paulkilroy/ChurchCam/README.md

# ChurchCamController

## TODO

- [ ] Make auto center
- [ ] Add settings to webserver
- [x] Make scad with bigger screen
