paulkilroy/ChurchCam/docs/pinout.html

Olimex ESP32-PoE · WROOM & WROVER

# ChurchCam Remote Pinout

The board as it really sits — both GPIO headers in physical pin order. The joystick and buttons wire to the header pins; the display plugs into the UEXT connector beside it. One wiring runs on both modules, so the two recall buttons share GPIO34 as a single analog input (one resistor) and GPIO16 is left free (the WROVER's PSRAM owns it). Colours mark what each pin does. Below: the button ladder, then the joystick detail (orientation, polarity, wiring), the full wire-by-wire list, and a bench test.

Pan · GPIO33 Tilt · GPIO35 Zoom · GPIO36 Buttons VCC (3V3) GND On-chip / reserved Display net (via UEXT)

## Wiring

The board & the UEXT connector

Both headers, pin-for-pin. The joystick's three wipers — pan, tilt, zoom — and the buttons land on the right header; power rails on the left. Both recall buttons share GPIO34 as one analog input (below). Dashed pins are the display's nets, wired through UEXT — don't reuse them. GPIO16 and GPIO0 sit empty: each is free on a WROOM but taken by the WROVER (PSRAM / ETH clock), so the one wiring fits both.

Eight wires go to the panel — teal is the display bus, red VCC, black GND. Pin 4 (GPIO36) is the zoom wiper, wired on the EXT header (dotted), not through this ribbon — pick one connector for it, never both. Pin 5 (GPIO16) is now left empty: it's the old recall-1 pin, freed because the WROVER module uses GPIO16 for PSRAM.

Drawn from the wiring (back) side, so left-to-right matches the panel: Recall 2, Recall 1, onboard BUT1, then Override. Recall 1, Recall 2 and BUT1 share one input-only pin, GPIO34, held high by the onboard 10k pull-up (R48) — just one resistor, no second run to the header: Recall 1 is a bare button to GND (ADC ≈ 0); bridge a single 10k straight from Recall 1 to Recall 2, other leg to GND (ADC ≈ 2048); the onboard BUT1 (220Ω, ADC ≈ 88) doubles as a spare Recall 1. Bands: >3000 none · 1200–3000 recall 2 · <1200 recall 1 (Recall 1's hard short wins, so both-press = recall 1; no dead zone). Override is separate — its own pin GPIO32 with an internal pull-up, a plain button to GND, read as a digital LOW.

Room to expand? Not on the dual-module wiring.

The two pins that look spare are each taken by the WROVER — so for one wiring that runs on both modules, leave both empty:

- GPIO0 — free on a WROOM, but on a WROVER it carries the Ethernet 50 MHz clock (the WROVER clocks ETH out on GPIO0 because PSRAM took GPIO16/17). A button there would break Ethernet. Even on a WROOM it's a boot-strap pin — pressed during power-up/reset it drops the chip into firmware-download mode — so it's a poor home for a frequently-used control.
- GPIO16 — also free on a WROOM only. On a WROVER the module's PSRAM owns GPIO16/17, so a button there breaks the module.
- GPIO1 and GPIO3 are the USB serial console (UART0 TX/RX, through the CH340). Free only if you give up serial logging and USB flashing — you'd rely on OTA updates instead.
- GPIO2 is the display backlight (via UEXT) and itself a strapping pin — not available.
- Everything else is taken (joystick, buttons, display) or committed: GPIO34/35/36/39 are input-only (joystick axes + the recall buttons), GPIO39 also reads the supply voltage, and the rest of the chip is the Ethernet PHY. To add controls you'd combine more buttons onto the existing ladder, add an I²C/ADC expander, or free up the serial pins. (On a WROOM-only build, GPIO0 and GPIO16 open back up.)

## Orientation · polarity · wiring

Joystick detail

Three identical, unlabeled pots and a stick that mounts either way — so wire by colour and motion, never by which pot "looks like" pan, then prove it on the display radar before install.

Green = Pan · GPIO33 Yellow = Tilt · GPIO35 Blue = Zoom · GPIO36 Red = VCC 3V3 White = GND

1Which pot is which — by motion

The pots are twins — identify them by motion, not by looks. Shown from the wiring side (mirror of the operator's view), so Tilt sits on the right here — on the front it's on the left. A gimbal pot sits perpendicular to the axis it senses: the pot across the left↔right travel is PAN, the one across up↕down is TILT. Foolproof check: waggle the stick left–right and watch the two pots — the shaft that turns is Pan (green). Waggle up–down — that one is Tilt (yellow). The ZOOM pot is the twist knob on top.

2Polarity — this sets direction

Hold the pot in your hand, stick pointing up and the three legs facing you — a hold-in-hand reference, so it doesn't matter which way the pot ends up mounted. Left leg = VCC (red), centre = wiper (the axis colour), right leg = GND (white). Wire both gimbal pots (Pan & Tilt) exactly this way. Swapping a pot's two outer legs reverses its voltage sweep and inverts that axis — that's the "left goes right" failure. The ZOOM knob already has this baked into its 3-wire lead: red = VCC, white = GND, black = wiper (extend the black with your blue wire).

3Wire it — one power rail, three wipers

The red (VCC) and black (GND) wires are one shared rail — the board's 3V3 and GND link straight through all three pots. Order doesn't matter — it's one continuous bus (you solder it from the far end: zoom→tilt→pan→board). Only the centre wiper is unique to each: Zoom → GPIO36, Tilt → GPIO35, Pan → GPIO33. Board pins are in physical header order — note GPIO34, the recall-button pin, sits in the gap between Tilt and Pan and takes no joystick wire.

The one thing that silently bites you: keep every pot's VCC on the left / GND on the right (the polarity card above) as you chain them. It's easy to flip a pot end-for-end while soldering the daisy-chain — and a flipped pot inverts that axis. If two axes come out swapped, you crossed the green/yellow wipers; if one axis is reversed, you flipped that pot's outer legs.

## Connection list

Wire by wire, by where it lands

Component | Pin | Lands on
Display → UEXT connector (10-wire ribbon)
VCC | 3V3 | UEXT 1
GND | GND | UEXT 2
RESET | GPIO4 | UEXT 3
MOSI | GPIO13 | UEXT 6
CS | GPIO15 | UEXT 7
LED (backlight) | GPIO2 | UEXT 8
SCK | GPIO14 | UEXT 9
DC | GPIO5 | UEXT 10
Joystick & buttons → right header (EXT2)
Pan wiper | GPIO33 | header · ADC1
Tilt wiper | GPIO35 | header · ADC1
Zoom wiper | GPIO36 | header · ADC1
Recall 1 button | GPIO34 | bare button → GND (no resistor; onboard BUT1 too)
Recall 2 button | GPIO34 | 10k bridged from Recall 1 → button → GND
Override button | GPIO32 | header
Power rails → left header (EXT1)
Joystick VCC rail | 3V3 | left header
Joystick / button ground | GND | left header
On-chip on WROVER — leave empty (free on a WROOM)
Ethernet clock (WROVER) | GPIO0 | left header · also the boot pin
PSRAM (WROVER) | GPIO16 | right header

## Testing

Prove the board & buttons before you install

Orientation (best-guess reference — the radar is the real judge): mount the controller so the operator's “up” on the stick is physically up and the wire lead exits toward the operator. Because Pan/Tilt were identified by motion (card 1), the exact mount doesn't change the wiring — but it must match what the operator expects, and the test below confirms it.

1. Power the controller and look at the radar on its display.
2. Push the stick UP → the dot must go UP. Push RIGHT → dot RIGHT. Push LEFT/DOWN → matching.
3. Twist zoom in → the zoom bar fills up; twist out → it empties.
4. Buttons: press Recall 1, Recall 2 and Override in turn. Recall 1 & 2 share GPIO34 — watch the serial log line recall ladder ADC=…: rest ≈ 4095, Recall 2 ≈ 2048, Recall 1 ≈ 0 (onboard BUT1 ≈ 88 also reads as Recall 1). Both at once → ≈ 0 = Recall 1 (its hard short wins; no both-press dead zone). Each button must land in its own band, and Override (its own pin, GPIO32) must read separately.
5. All four directions, zoom, and every button correct → ship it. Anything wrong → the table:

What you see | What's wrong | Fix
Up/down moves the camera sideways & left/right moves it up/down | Pan & Tilt wipers crossed | Swap the green and yellow wires at GPIO33 ↔ GPIO35
Push UP → dot goes DOWN | Tilt axis inverted | Swap the Tilt pot's two outer legs (red ↔ white)
Push RIGHT → dot goes LEFT | Pan axis inverted | Swap the Pan pot's two outer legs (red ↔ white)
Zoom in empties the bar (backwards) | Zoom axis inverted | Swap the Zoom knob pot's two outer legs
An axis doesn't move the dot at all | Wiper open, or VCC/GND not reaching that pot | Check that pot's centre wiper to its GPIO, and that the red/white rail is unbroken through the chain

Field option (no soldering): a mis-wired unit can also be corrected in software — a per-axis Invert / swap in the config page — if we add it. Say the word and I'll build it so a bad unit is a checkbox, not a rework.

ChurchCam · Olimex ESP32-PoE, WROOM & WROVER (one wiring) · ILI9341 over native HSPI, on UEXT · JH-D400X joystick: Pan GPIO33 / Tilt GPIO35 / Zoom GPIO36, VCC-left polarity, verify on the display radar · from Display.cpp + Pinouts[REV_OLIMEX] · pins & header order verified against the ESP32-PoE Rev.E schematic
