paulkilroy/ChurchCam/docs/design/header-and-edge-states.html

ChurchCam · header + buttons + edge states · v2

# Signal bars, subsystem pills, and live button feedback Plus the fixed edge states — Connecting now amber with a real wordmark, and Network-lost matches what the firmware actually does (just keeps retrying).

The header now folds three things into one strip: how the device is connected, the state of the switcher, and a flash whenever you press a physical button.

## The header — signal + subsystem pills

Wi-Fi strength bars + host/IP/RSSI on the left; the switcher's state as colored pills on the right. Normal service:

4-bar signal · churchcam · 10.13.37.2 · -54 dB | ATEM ✓ · big ● ON AIR (off air = dim outline)

## Button-press pills

Each press flashes a pill in the header's right slot. A tap recalls a preset (brief green flash); holding OVERRIDE while you tap saves the current position — which triggers the full-screen confirmation in the next section.

OVERRIDE held — red, driving the PROGRAM camera

Tap a preset — RECALL (green flash)

Idle — status pills showing

Maps to PIN_OVERRIDE, PIN_RECALL_1, PIN_RECALL_2. Override is held (red while driving live). Tap = recall; OVERRIDE + tap = save → full-screen popup. Pill text is the same size as ON AIR now.

## Edge states — fixed

Distinct full-screen layouts. Setup + Connecting/Lost share the amber "you need to do something / hang tight" language; hard failures go red.

### Preset saved (full-screen)

~2.5s takeover after OVERRIDE + tap. Shows the camera and the saved P/T/Z position, then the console returns. The control loop keeps running underneath.

when: OVERRIDE held + preset button tapped

### Setup / AP mode

Reachable only on its own hotspot. SSID + IP shown like fields to copy.

when: hotspot up, no station/Ethernet link

### Connecting / reconnecting

Amber now, wordmark up top. Says whether it's a first connect or a reconnect — but no fake countdown; it just keeps trying.

when: no IP yet (boot or link drop)

### No ATEM (degraded)

Console still drives directly; tally box becomes an amber DIRECT panel. Text no longer overlaps the radar.

when: network up, ATEM unreachable

### Updating firmware

Full-screen progress + a hard "do not power off." Locks out everything during OTA.

when: /update OTA in progress

### Input has no camera

ATEM on a laptop/media input → says so instead of a dead tally.

when: active input has no camera IP

On "network lost": the firmware doesn't time-out to the AP after a drop — if Wi-Fi was working it just retries forever (restart to reconfigure). So there's no separate red "lost" screen with a countdown; the Connecting screen simply reads Reconnecting… when it had a link before. Faithful to the code, same as our rule for the ATEM sim.
