paulkilroy/ChurchCam/docs/design/screen-concepts.html

ChurchCam · 320×240 · Console + Radar — refined

# Now with a live camera bus The active camera's status reads in caps inside its tally box; the old PGM/PVW text becomes a strip of all 8 inputs — dim when offline, tallied PRG / PVW when live.

One glance now tells you which camera you're driving and its state, where the joystick is, what the whole switcher bus looks like, and whether you're streaming — without a single ambiguous label.

Console + Radar + 8-input camera strip · rendered at ~2.3× (real screen is 320×240)

## The camera strip · 8 inputs

1PRG

PROGRAM

2PVW

PREVIEW

3

connected

4!

configured,
no reply

5

not configured

The tile you're driving gets a white underline. Program/Preview come from getProgramInputVideoSource() / getPreviewInputVideoSource(); the rest map to cached camera status — amber "!" = has an IP but not responding (CAMERA_DOWN), dim = no IP set (CAMERA_NA).

## What's on screen

- Tally box — frame color = Program (red) / Preview (green) / Off; caps status inside: number, name, ● reachable
- Radar — pan/tilt dot live; ring matches tally color; zoom on the right rail
- Camera strip — all 8 inputs, dim when offline, PRG/PVW tally badges
- On-Air pill — livestream state, kept separate from Program
- Histogram — TX/sec, thin along the bottom
- Open Q: 8 tiles across 320px are ~35 px — number + tally read fine, but no room for names. OK?

Ready to build → this is a clean, buildable layout. Say go and I'll implement it in Display.cpp against the sim, where you'll see the real pixel-font render and the strip/radar actually move — then we fine-tune spacing, the caps status wording, and colors on real glass.
