paulkilroy/ChurchCam/docs/manual.html

◐ theme

ChurchCam · Olimex ESP32-PoE PTZ Controller

# Operator & Setup Manual

ChurchCam is a joystick controller for pan/tilt/zoom cameras. It follows your ATEM switcher's preview bus — so you always drive whatever camera is cued next — and speaks both VISCA and ONVIF over Ethernet or Wi-Fi. This guide covers the on-screen display, the joystick and buttons, first-time setup, and the web configuration page.

320×240 display3-axis joystickoverride + 2 preset buttonsVISCA · ONVIFweb config

## 1The screen at a glance

The main "console" screen shows everything you need while driving: which camera you're on and whether it's live, where the joystick is, the whole switcher bus, and whether the device is talking.

The console — a full breakdown of every region is in Reading the display.

## 2Joystick & buttons

Three physical controls do everything. The joystick drives the camera; the three buttons handle live override and presets.

Control | Action
Joystick — left / right | Pan the camera
Joystick — up / down | Tilt the camera
Joystick — zoom axis | Zoom in / out
OVERRIDE button (hold) | Drive the Program (live) camera instead of Preview — the tally box turns red. Also the "shift key" for saving presets.
PRESET 1 / 2 — tap | Recall that preset (camera moves to the saved position)
OVERRIDE + PRESET 1/2 | Save the current position to that preset

Rule of thumb

A quick tap on a preset button recalls. To save, hold OVERRIDE and tap the preset button — you'll get a full-screen "PRESET SAVED" confirmation.

## 3Reading the display

Every colour and pill on the screen means something specific. Here's the whole vocabulary.

### The header

1. Signal — Wi-Fi strength bars, or a wired icon on Ethernet.
2. Host & IP — the device's hostname, address, and Wi-Fi signal (dBm).
3. ATEM — green pill when the switcher is connected; amber NO ATEM when it isn't.
4. ON AIR — big and red when the switcher is livestreaming; dim OFF AIR otherwise — not the same as a camera being on Program.

### The whole console

1. Status header — signal, hostname/IP, ATEM link, and the big ON AIR / OFF AIR streaming indicator.
2. Tally box — the camera you're driving; the frame is red on Program, green on Preview.
3. Radar — live pan/tilt position (dot) and zoom (right rail).
4. Camera bus — all 8 inputs at a glance, with tally and connection state.
5. TX graph — commands the device is sending, per second.

### Tally — Program vs Preview

The tally box frame tells you, at a glance, whether the camera you're driving is live:

Frame | Meaning
PROGRAM (red) | This camera is live on air. Move with care.
PREVIEW (green) | This camera is cued next. Safe to reframe.
OFF (grey) | Not on either bus.

### The camera bus strip

All eight inputs, always visible. Each tile shows the input number, its tally, and whether a camera is actually reachable there:

Tile | State
red · PRG | On Program (live)
green · PVW | On Preview (next)
grey | Connected, reachable
amber · ! | Configured but not responding
dim | No camera configured on this input

A white underline marks the tile you're currently driving.

### Radar & TX graph

The radar crosshair shows live pan/tilt as a moving dot, with zoom on the right rail; both turn red when you're on a Program camera. The TX graph along the bottom is a running count of commands the device sends each second — a quiet heartbeat that lets you see it's actually talking to the cameras.

## 4Driving cameras & presets

You never pick a camera number by hand — the controller follows the switcher.

### Which camera you're driving

By default the controller drives whatever camera is on the ATEM's Preview bus. Cue a camera to preview on the switcher, and the joystick moves that camera — the tally box shows it green (PREVIEW).

Need to nudge the shot that's live? Hold OVERRIDE — now you're driving the Program camera, and the tally box (and radar) turn red so you never forget the shot is on air. Release to go back to driving Preview.

### Presets

- Recall a preset — tap PRESET 1 or 2. The camera moves to the saved shot; the header flashes PRESET n RECALL.
- Save a preset — frame the shot, then hold OVERRIDE and tap PRESET 1 or 2. A full-screen confirmation shows the camera and the position you saved.

## 5Button feedback & saving

Every button press gets visible feedback so you know the device saw it.

#### Override held

#### Preset recalled (tap)

### Saving a preset — the confirmation

Holding OVERRIDE and tapping a preset saves the shot and takes over the whole screen for a couple of seconds. The joystick keeps working underneath, then the console returns.

1. Which preset — the slot you just saved to.
2. Camera — the number and name it was saved for.
3. Position — the pan / tilt / zoom you stored, shown as bars.
4. Recall — tap the same button later to return to this shot.

## 6First-time setup

Out of the box (or after an erase) the device has no network, so it hosts its own hotspot for configuration.

1. Join its Wi-Fi — on your phone or laptop, connect to the ptz-setup network.
2. Open the config page — browse to 192.168.4.1 (shown on screen).
3. Enter your Wi-Fi, the ATEM's IP, and your cameras — then Save. The device reboots and joins your network.

After setup

Once it's on your network the screen shows the device's real IP and hostname (churchcam by default) — browse to that hostname or IP anytime to change settings.

## 7The configuration page

The web page (served by the device) has four tabs: Status, Config, Logs, and Firmware. Browse to the device's hostname (churchcam.local) or IP to open it.

http://churchcam.local

Church Cam Controller

PTZ made EZ

StatusConfigLogsFirmware

Network Config

Network Name (SSID)

KilroyNetwork

Network Password

••••••••••

Static IP Address?

ATEM Mini Pro IP

10.0.4.40

CAM1 [ATEM In1]

VISCA

UDP

10.0.4.62

52381

CAM2 [ATEM In2]

VISCA

TCP

10.0.4.63

52382

CAM3 [ATEM In3]

ONVIF

TCP

10.0.4.64

8083

CAM4 [ATEM In4]

ONVIF

TCP

10.0.4.65

8084

Discover Cameras

Submit

The Config tab, matching the real page: form-floating network fields and one input-group row per camera (name · VISCA/ONVIF · UDP/TCP · IP · port).

### Status

A live read-out of the network interfaces (Ethernet / Wi-Fi / Hotspot with their IPs), the ATEM switcher, and every camera's reachability — the same up / down / not-configured states you see on the device's camera strip.

http://churchcam.local

Church Cam Controller

PTZ made EZ

StatusConfigLogsFirmware

Network | IP | SSID | Info
Ethernet | 10.0.4.40 | — | —
WiFi | — | — | off
Hotspot | — | ptz-setup | off

Device | IP | Proto | Port
ATEM Mini Pro | 10.0.4.40 | TCP | —
Camera 1 | 10.0.4.62 | VISCA UDP | 52381
Camera 2 | 10.0.4.63 | VISCA TCP | 52382
Camera 3 | 10.0.4.64 | ONVIF | 8083

The Status tab — the real two-table layout (Networks, then Device & cameras) with colored rows for up / off / no-reply.

### Config

Network Config

Field | What it's for
SSID / Network Password | Your Wi-Fi network (leave blank to stay on Ethernet only)
Static IP | Turn on to assign a fixed address instead of DHCP
Static IP / Subnet Mask / Gateway | The fixed address details, when Static IP is on

Device Config

Field | What it's for
ATEM Mini IP | The switcher's address, so tally & camera selection follow it
Per camera — Type | VISCA or ONVIF (the control protocol)
Per camera — Transport | UDP or TCP (ONVIF is always TCP)
Per camera — IP & Port | Where to reach that camera

Discover Cameras

Rather than typing addresses, hit Discover Cameras — the device probes the network (VISCA broadcast + ONVIF discovery) and lists what it finds so you can assign each to an input.

### Logs

A live log with Info / Debug / Warn / Error filters — handy when a camera isn't responding and you want to see what the device is sending.

### Firmware

Upload a new firmware file to update the device over the air. While it writes, the device screen shows a full-screen progress bar and a DO NOT POWER OFF warning, then reboots into the new version.

## 8Screen states & troubleshooting

When something's not normal, the screen changes entirely — it tells you what's wrong instead of showing a broken console.

#### Connecting / reconnecting

Waiting for the network. If it says Reconnecting, the link dropped and it's retrying — restart the device if you changed Wi-Fi settings.

#### No ATEM

The switcher is unreachable. You can still drive a camera directly, but there's no tally. Check the ATEM IP in Config.

You see… | It means | Do
SETUP MODE (yellow) | No network configured | Join ptz-setup, browse to 192.168.4.1
Connecting / Reconnecting | No IP yet, or link dropped | Wait; restart if you changed Wi-Fi
NO ATEM pill | Switcher unreachable | Check the ATEM IP & network
Amber ! on a camera tile | Camera configured but not answering | Check the camera's IP/power/network
NO CAMERA HERE | Preview is on an input with no camera (laptop, media) | Cue a camera input to control it

## 9Quick reference

#### Buttons

Tap preset | Recall
Hold OVERRIDE + tap preset | Save
Hold OVERRIDE | Drive the live camera

#### Colours

Red | Program / live / on air
Green | Preview / connected / OK
Amber | Attention — no reply / setup
Dim | Not configured / inactive

ChurchCam · operator & setup manual · device screens rendered at scale. Default hostname churchcam, setup network ptz-setup, setup address 192.168.4.1.
