paulkilroy/ChurchCam/src/ChurchCam.cpp

#include <Arduino.h>
#include <esp_mac.h>
#include "globals.h"


// SIM #include <DNSServer.h>  // For captive portal DNS redirect

#include <EEPROM.h>
#include <ATEMmin.h>

/* Module map
   ----------
   ChurchCam    - setup() + loop(); owns global state (ATEM, sim flag, pinouts)
   Controller   - joystick + buttons + the per-tick control loop; camera health poll
   Display      - operator console + edge-state screens (renders from JoystickState)
   Network      - eth/wifi bring-up, callbacks, static IP, DNS/mDNS, helper accessors
   CameraLink   - per-camera BSD-socket transport (UDP/TCP): camConnect/Send/Recv/Close
   Visca        - VISCA protocol: drive/zoom/preset commands, power-inquiry status
   Onvif        - ONVIF/SOAP protocol: PTZ + presets, TCP-reachability status
   Web          - PsychicHttp config/status pages, /ws telemetry, OTA upload
   Logging      - cross-task-safe log ring shared by the loop, WiFi task, and web task
*/

//Initialize global variables
// Didn't work in Simulator DNSServer dnsServer;
bool FirstTimeSetup = false;
ATEMmin atemSwitcher;
bool InSimulator = false;
bool PsramOk = false;   // set in setup(): true only on a WROVER-E with PSRAM up


// Indexed by HWRev (REV_OLIMEX / REV_SIM).
// B1/B2/B3 = override / recall1 / recall2. The Simulator pinout must avoid the
// hardcoded TFT pins (2,4,5,13,14,15 -- see Display.cpp): pots on ADC1 (32/34/35),
// buttons on 25/26/27.
struct Pinouts_S Pinouts[REV_MODELS]{
  //                P.  T.  Z. B1. B2. B3 LED RST SLC SDA
  //  B1/B2/B3 = override / recall1 / recall2. override=32 (its own digital pin).
  //  recall1+recall2 share GPIO34 as an ANALOG RESISTOR LADDER (recall1=255 here
  //  means "no discrete pin" -- read via the ladder on the recall2 pin, 34). This
  //  frees GPIO16, which is unusable on ESP32-POE-WROVER boards (PSRAM owns 16/17).
  //  Ladder: onboard R48 10k pull-up on GPIO34; recall1 via 10k, recall2 via 3.3k,
  //  onboard BUT1 (220R) reads as recall2. See readRecallButtons() in Controller.cpp.
  { "OLIMEX POE",  33, 35, 36, 32, 255, 34,  2, 255, 16, 13 },  // NOTE LED is on GPIO2 which does nothing on this board
  { "Simulator",   34, 35, 32, 25, 26, 27,  2, 255, 22, 21 },
  // ADC notes (ESP32): ADC2 does NOT work while WiFi is on. ADC1 = GPIO32-39,
  // ADC2 = GPIO0,2,4,12-15,25-27. INPUT_PULLUP works on 14,16-19,21-23,25-27.
};
int HWRev;
Settings settings;

//Perform initial setup on power on
void setup() {
  // Start Serial
  Serial.begin(115200);

  // FIRST thing: bring the panel up and paint the "Connecting" screen. The ILI9341
  // powers on white with its backlight lit, so every millisecond before this shows
  // as a white screen. Nothing the connecting screen draws needs serial, settings,
  // or the network, so it goes ahead of the serial-settle delay and everything else.
  displaySetup();
  { JoystickState splash = { 0, 0, 0, 0, 0, 0 }; displayLoop(splash); }

  /*
  for (int i = 0; i < 20; i++) {
    delay(100);
    size_t l = Serial.write("hi\n");
    Serial.printf("delaying startup: %d -- %d\n", i, l);
  }*/
  delay(1000);
  logi("######################## Serial Started");

  // Pre-create newlib's stdio/UART lock from the main task. The ESP-IDF mDNS
  // component does a raw printf() from the lwIP/tcpip thread on packet receive; if
  // that printf is the FIRST use of newlib stdio, the UART VFS lock is created
  // lazily right there -- and creating a mutex in that context aborts (busy-LAN
  // mDNS multicast -> crash loop). Our logi() uses a lower-level UART path, so it
  // never creates that lock. Touching stdio here, up front, creates the lock now
  // so the tcpip thread just reuses it. (Heap is fine; this is a lock-init-context
  // bug, not OOM. See the boot-loop investigation: abort() at lock_init_generic
  // under mdns receive -> vprintf -> uart_write.)
  printf("\n");
  fflush(stdout);
  fputc('\n', stderr);
  fflush(stderr);

  // Board check: this firmware is built with PSRAM (WROVER-E). PSRAM gives the
  // heap the ~4 MB it needs; without it the device runs on ~300 KB of internal
  // RAM, runs out of heap within minutes, and crashes (null-deref under OOM).
  // Flashed onto a WROOM-32UE, PSRAM won't init AND Ethernet is dead (the PSRAM
  // build claims GPIO17, the WROOM's ETH clock). Shout about it loudly.
  PsramOk = psramFound() && ESP.getPsramSize() > 0;
  if (PsramOk) {
    logi("PSRAM OK: %u KB total, %u KB free (WROVER-E confirmed)",
         (unsigned)(ESP.getPsramSize() / 1024), (unsigned)(ESP.getFreePsram() / 1024));
  } else {
    for (int i = 0; i < 3; i++) {
      loge("**************************************************************");
      loge("*  WRONG BOARD -- NO PSRAM DETECTED                          *");
      loge("*  This build requires a WROVER-E module (PSRAM on 16/17).   *");
      loge("*  On a WROOM it will run out of heap and crash, and         *");
      loge("*  Ethernet will NOT work (PSRAM build claims GPIO17).       *");
      loge("*  Use a WROVER-E, or a WROOM build without -DBOARD_HAS_PSRAM.*");
      loge("**************************************************************");
    }
  }

  // Determine if we're in the simulator or not; it has a hard-coded MAC address.
  // Read the efuse base MAC directly -- on core 3.x WiFi.macAddress() returns
  // all-zeros until the WiFi stack is started, which is too late here.
  uint8_t mac[6];
  esp_read_mac(mac, ESP_MAC_WIFI_STA);
  char macStr[18];
  snprintf(macStr, sizeof(macStr), "%02X:%02X:%02X:%02X:%02X:%02X",
           mac[0], mac[1], mac[2], mac[3], mac[4], mac[5]);
  logi("MAC: %s", macStr);
  if( strcmp(macStr, "24:0A:C4:00:01:10") == 0 ) {
    InSimulator = true;
    FirstTimeSetup = true;
  }
  logi("InSimulator: %d", InSimulator);

  // Read settings from EEPROM. WIFI settings are stored seperately by the ESP
  if( !InSimulator ) {
    EEPROM.begin(sizeof(settings));  
    EEPROM.get(0, settings);
  }

  // Validate the EEPROM blob. A blank chip, or one written by an older/different
  // Settings layout, won't match the magic+version -> reset to defaults instead
  // of reading garbage. (Bump SETTINGS_VERSION whenever Settings changes.)
  if (settings.magic != SETTINGS_MAGIC || settings.version != SETTINGS_VERSION) {
    logi("EEPROM settings invalid (magic=0x%08x ver=%d) - resetting to defaults",
         settings.magic, settings.version);
    settings = {};
    settings.magic = SETTINGS_MAGIC;
    settings.version = SETTINGS_VERSION;
    FirstTimeSetup = true;
  }
  logi("FirstTimeSetup: %d", FirstTimeSetup);

  networkSetup();

  cameraControlSetup();

  logi("Done");
}

void loop() {
  // PSK SIM dnsServer.processNextRequest();

  // Start network services once, in loop context (not on the WiFi/ETH event task)
  networkServicesLoop();

  if (settings.switcherIP[0] != 0 && networkUp() ) {
    atemSwitcher.runLoop();
  }
  
  // A subnet scan takes over the loop (its probes block ~a few hundred ms each);
  // keep the web alive so the config page can poll /scanProgress for the bar.
  if (g_scanRunning) { scanTick(); webLoop(); return; }

  cameraControlLoop();

  webLoop();
}
