paulkilroy/ChurchCam/src/Visca.cpp

#include <Arduino.h>
#include <WiFi.h>

#include "globals.h"

// Another visca controller: https://github.com/misterhay/VISCA-IP-Controller
// https://github.com/International-Anglican-Church/visca-joystick
// wait wait time for a visca packet to come back from the camera

#define VISCA_ERROR(code) \
  logi("%s%s",displayString.c_str(),code); \
  return;

// digitalWrite(PIN_TRANSMIT, LOW);

//#define VISCA_DEBUG 1

byte visca_empty[256] = {};
byte visca_response[256] = {};


#define VISCA_HEADER_SIZE 8

#define VISCA_PWR_INQ_BYTE 2
byte visca_pwr_inq_bytes[] = { 0x01, 0x00, 0x00, 0x05, 0x00, 0x00, 0x00, 0x02, 0x81, 0x09, 0x04, 0x00, 0xFF };

byte visca_net_inq_bytes[] = { 0x02, 0x45, 0x4E, 0x51, 0x3A, 0x6E, 0x65, 0x74, 0x77, 0x6F, 0x72, 0x6B, 0xFF, 0x03 };

byte visca_set_bytes[] = { 0x01, 0x00, 0x00, 0x07, 0x00, 0x00, 0x00, 0x02, 0x81, 0x01, 0x04, 0x3f, 0x01, 0x02, 0xff };

#define RECALL_NUM_BYTE 13
byte visca_recall_bytes[] = { 0x01, 0x00, 0x00, 0x07, 0x00, 0x00, 0x00, 0x02, 0x81, 0x01, 0x04, 0x3f, 0x02, 0x02, 0xff };
//                            [payload ]  [ payload]  [   sequence number  ]  [           payload                    ]
//                              type        length        LSB big-endian
// Change bytes 12 and 13 for pan and tilt speed
#define PAN_SPEED_BYTE 12
#define TILT_SPEED_BYTE 13
#define PT_DIR1_BYTE 14
#define PT_DIR2_BYTE 15
byte visca_pt_drive_bytes[] = { 0x01, 0x00, 0x00, 0x09, 0x00, 0x00, 0x00, 0x02, 0x81, 0x01, 0x06, 0x01, 0x00, 0x00, 0x03, 0x03, 0xff };
//                                                                                    [    PT Drive   ][PSpd][TSpd][Direction] [TERM]

// 8x 01 04 07 2p FF
#define ZOOM_DIR_BYTE 12
#define ZOOM_TELE 2 << 8
#define ZOOM_WIDE 3 << 8
byte visca_zoom_bytes[] = { 0x01, 0x00, 0x00, 0x06, 0x00, 0x00, 0x00, 0x02, 0x81, 0x01, 0x04, 0x07, 0x00, 0xff };


// 8x 09 04 47 FF
byte visca_zoom_inq_bytes[] = { 0x01, 0x00, 0x00, 0x05, 0x00, 0x00, 0x00, 0x02, 0x81, 0x09, 0x04, 0x47, 0xff };
#define ZOOM_INQ_MIN 0x0000
#define ZOOM_INQ_MAX 0x6000
byte visca_zoom_inq_resp_bytes[] = { 0x01, 0x00, 0x00, 0x05, 0x00, 0x00, 0x00, 0x02, 0x00, 0x50, 0x0e, 0x0e, 0x0e, 0x0e, 0xFF };

uint32_t sequenceNumber = 1;

boolean pt_stopped = true;
boolean zoom_stopped = true;

int previousCamera = 0;

// Shared discovery result list (populated by VISCA and ONVIF discovery).
DiscoveredCamera discoveredCameras[MAX_DISCOVERED];
int numDiscoveredCameras = 0;

void resetDiscovered() {
  numDiscoveredCameras = 0;
}

// Append a camera, de-duplicated by ip+port (so re-probes and multi-response
// cameras don't create duplicates). Returns true if a new entry was added.
bool addDiscovered(IPAddress ip, uint16_t port, uint8_t type, uint8_t transport, uint8_t headers, const char *name) {
  for (int i = 0; i < numDiscoveredCameras; i++) {
    if (discoveredCameras[i].ip == ip && discoveredCameras[i].port == port) return false;
  }
  if (numDiscoveredCameras >= MAX_DISCOVERED) return false;
  DiscoveredCamera &c = discoveredCameras[numDiscoveredCameras++];
  c.ip = ip;
  c.port = port;
  c.type = type;
  c.transport = transport;
  c.headers = headers;
  strlcpy(c.name, name, sizeof(c.name));
  return true;
}

// PSK BUG Keep a UDP socket around for each camera so I'm not creating each one every message
// SONY MANUAL:
// If the multiple commands are send without waiting for the reply, the possibility of non-execution of the command and errors due to
// buffer overflow become high, because of limitations of order to receive commands or execution interval of command.
// It may cause efficiency to be reduced substantially.

void visca_send(String command, byte packet[], int size, int cameraNumber, boolean waitForAck = false, boolean waitForComplete = false, byte response[] = visca_response, int msgType = CAM_MSG_NONE) {
  String returnCode = "OK";
  String displayString = String(sequenceNumber) + String(" - ") + command + String(" - ");
  //byte response[256] = { 0x00, 0x00, 0x00, 0x00, 0x00, 0x00, 0x00, 0x00, 0x00, 0x00, 0x00, 0x00, 0x00, 0x00 };
  memset(response, 0, VISCA_RESPONSE_SIZE);

  // digitalWrite(PIN_TRANSMIT, HIGH);

  // Valid indices are 0..NUM_CAMERAS (NUM_CAMERAS is the hidden broadcast camera);
  // arrays are sized NUM_CAMERAS+1, so NUM_CAMERAS+1 would be out of bounds.
  if (cameraNumber < 0 || cameraNumber > NUM_CAMERAS) {
    loge("Invalid cameraNumber: %d\n", cameraNumber);
    VISCA_ERROR("E99");
  }

  if (!networkUp() || settings.cameraIP[cameraNumber][0] == 0) {
    VISCA_ERROR("E98");
  }

  // Don't keep re-sending an identical drive command to the same camera. Dedup
  // is per (camera, msgType) so interleaved pan/tilt and zoom don't clobber each
  // other, and only drive commands opt in (msgType != CAM_MSG_NONE): inquiries
  // and one-shots pass CAM_MSG_NONE so they always go out -- suppressing an
  // inquiry would return the zeroed response above and read as CAMERA_DOWN.
  if (msgType != CAM_MSG_NONE && camIsRepeat(cameraNumber, msgType, packet, size)) {
#ifdef VISCA_DEBUG
    logd("Duplicate %s packet on camera %d: ignoring", command.c_str(), cameraNumber + 1);
    printBytes(packet, size);
#endif
    // digitalWrite(PIN_TRANSMIT, LOW);
    return;
  }

  //  Note the socket number - byte 9 is not used on send, only receive
  //  And address number - byte 8 is locked to 1 on IP

  // Write the sequence number into the visca packet
  writeBytes(sequenceNumber, packet, 4);
  sequenceNumber++;

  // Trim off the header if needed
  int startPos = 0;
  int sendSize = size;
  int successByte = 9;

  /**
      Reply Packet Note
      Ack X0 4Y FF Y = socket number
      Completion (Commands) X0 5Y FF Y = socket number
      Completion (Inquiries) X0 5Y ... FF Y = socket number
      X = 9 to F: Address of the unit + 8
    * * Locked to “X = 9” for VISCA over IP
      Error Packet Description
      X0 6Y 01 FF Message length error
      X0 6Y 02 FF Syntax Error
      X0 6Y 03 FF Command buffer full
      X0 6Y 04 FF Command canceled
      X0 6Y 05 FF No socket (to be canceled)
      X0 6Y 41 FF Command not executable
      X = 9 to F: Address of the unit + 8, Y = socket number
  */
  if (!settings.cameraHeaders[cameraNumber]) {
    startPos = VISCA_HEADER_SIZE;
    sendSize -= VISCA_HEADER_SIZE;
    successByte -= VISCA_HEADER_SIZE;
  }

  if (NETWORK_SUCCESS != camConnect(cameraNumber)) {
    VISCA_ERROR("E97");
  }

  // Before an inquiry (we're about to read its reply), drop any stale replies left
  // queued by earlier fire-and-forget drive/recall commands -- otherwise we read one
  // of those instead of this inquiry's reply and misreport the camera as DOWN.
  if (waitForAck) camFlush(cameraNumber);

  if (NETWORK_SUCCESS != camSend(cameraNumber, &packet[startPos], sendSize)) {
    VISCA_ERROR("E96");
  }

  if (waitForAck) {
    int len = camRecv(cameraNumber, response, VISCA_RESPONSE_SIZE);
    if (NETWORK_ERROR == len) {
      VISCA_ERROR("E95");
    } else if (NETWORK_TIMEOUT == len) {
      VISCA_ERROR("EATO");  // PSK Should we try to resend here? -- Resend should happen automatically because we didn't copy
                            // the current command into the prev command buffer
    }

    // Check for valid ACK
    if (0x60 == (response[successByte] & 0xF0)) {
      logw("Invalid ACK: ");
      printBytes(response, 20);
      waitForComplete = false;
      String error = "EA" + String(stringBytes(&response[successByte + 1], 1));
      VISCA_ERROR(error.c_str());
    } else if (0x50 == (response[successByte] & 0xF0)) {
      waitForComplete = false;
    }
  }

  if (waitForComplete) {
    int len = camRecv(cameraNumber, response, VISCA_RESPONSE_SIZE);
    if (NETWORK_ERROR == len) {
      VISCA_ERROR("E93");

    } else if (NETWORK_TIMEOUT == len) {
      VISCA_ERROR("ECTO");
    }
    // Check for valid COMPLETE
    if (0x60 == (response[successByte] & 0xF0)) {
      logw("Invalid COMPLETE: ");
      printBytes(response, 20);
      String error = "EC" + String(stringBytes(&response[successByte + 1], 1));
      VISCA_ERROR(error.c_str());
    }
  }

  // Record this send for dedup only after it succeeded (matches the old
  // behavior: a failed send doesn't update history, so it will be retried).
  if (msgType != CAM_MSG_NONE) camNoteSent(cameraNumber, msgType, packet, size);
  previousCamera = cameraNumber;

  logi("%s%s", displayString.c_str(), returnCode.c_str());
  // digitalWrite(PIN_TRANSMIT, LOW);
  //Serial.println("[done]");
}

// Maybe Break this into viscaPTDrive() and viscaZoom()
void ptzDrive(int panSpeed, int tiltSpeed, int zoomSpeed) {
  int activeCamera = getActiveCamera();

  // First check to see if we switch the preview camera in the middle of a pan/tilt or zoom
  // If so, stop the movement on the previous camera
  // Serial.printf("ptzLoop: previousCamera: %d, pt_stopped: %d, zoom_stopped: %d\n", previousCamera, pt_stopped, zoom_stopped);
  if (previousCamera != activeCamera) {
    if (!pt_stopped) {
      visca_pt_drive_bytes[PT_DIR1_BYTE] = 0x03;
      visca_pt_drive_bytes[PT_DIR2_BYTE] = 0x03;
      logw("Stopping pt on previous camera\n");
      visca_send("PT-DRIVE", visca_pt_drive_bytes, sizeof(visca_pt_drive_bytes), previousCamera, false, false, visca_response, CAM_MSG_PANTILT);
    }
    if (!zoom_stopped) {
      visca_zoom_bytes[ZOOM_DIR_BYTE] = 0x0;
      logw("Stopping zoom on previous camera\n");
      visca_send("ZOOM", visca_zoom_bytes, sizeof(visca_zoom_bytes), previousCamera, false, false, visca_response, CAM_MSG_ZOOM);
    }
    // Newly selected camera: clear its dedup history so the command below is
    // always sent explicitly rather than suppressed against its stale last state.
    camResetDedup(activeCamera);
  }

  // ptzDrive sends two packets per call (pan/tilt + zoom). visca_send dedups each
  // per (camera, message-type), so holding the stick steady sends each command
  // once and then suppresses the identical repeats until the speed changes.

  boolean pt_stopping = false;
  boolean zoom_stopping = false;

  visca_pt_drive_bytes[PAN_SPEED_BYTE] = byte(abs(panSpeed));
  visca_pt_drive_bytes[TILT_SPEED_BYTE] = byte(abs(tiltSpeed));

  if (panSpeed > 0 && tiltSpeed > 0) {  // upright
    visca_pt_drive_bytes[PT_DIR1_BYTE] = 0x02;
    visca_pt_drive_bytes[PT_DIR2_BYTE] = 0x01;
  } else if (panSpeed < 0 && tiltSpeed < 0) {  // downleft
    visca_pt_drive_bytes[PT_DIR1_BYTE] = 0x01;
    visca_pt_drive_bytes[PT_DIR2_BYTE] = 0x02;
  } else if (panSpeed > 0 && tiltSpeed < 0) {  // downright
    visca_pt_drive_bytes[PT_DIR1_BYTE] = 0x02;
    visca_pt_drive_bytes[PT_DIR2_BYTE] = 0x02;
  } else if (panSpeed < 0 && tiltSpeed > 0) {  // upleft
    visca_pt_drive_bytes[PT_DIR1_BYTE] = 0x01;
    visca_pt_drive_bytes[PT_DIR2_BYTE] = 0x01;
  } else if (panSpeed > 0) {  // right
    visca_pt_drive_bytes[PT_DIR1_BYTE] = 0x02;
    visca_pt_drive_bytes[PT_DIR2_BYTE] = 0x03;
  } else if (panSpeed < 0) {  // left
    visca_pt_drive_bytes[PT_DIR1_BYTE] = 0x01;
    visca_pt_drive_bytes[PT_DIR2_BYTE] = 0x03;
  } else if (tiltSpeed > 0) {  // up
    visca_pt_drive_bytes[PT_DIR1_BYTE] = 0x03;
    visca_pt_drive_bytes[PT_DIR2_BYTE] = 0x01;
  } else if (tiltSpeed < 0) {  // down
    visca_pt_drive_bytes[PT_DIR1_BYTE] = 0x03;
    visca_pt_drive_bytes[PT_DIR2_BYTE] = 0x02;
  } else {  // stop
    visca_pt_drive_bytes[PT_DIR1_BYTE] = 0x03;
    visca_pt_drive_bytes[PT_DIR2_BYTE] = 0x03;
    pt_stopping = true;
  }
  if (!(pt_stopped == true && pt_stopping == true)) {
    visca_send("PT-DRIVE", visca_pt_drive_bytes, sizeof(visca_pt_drive_bytes), activeCamera, false, false, visca_response, CAM_MSG_PANTILT);
  }

  if (zoomSpeed > 0) {
    visca_zoom_bytes[ZOOM_DIR_BYTE] = 0x02;  //ZOOM_TELE + byte(abs(zoomSpeed));
  } else if (zoomSpeed < 0) {
    visca_zoom_bytes[ZOOM_DIR_BYTE] = 0x03;  // ZOOM_WIDE + byte(abs(zoomSpeed));
  } else {
    visca_zoom_bytes[ZOOM_DIR_BYTE] = 0x0;  // Stop
    zoom_stopping = true;
  }
  if (!(zoom_stopped == true && zoom_stopping == true)) {
    visca_send("ZOOM", visca_zoom_bytes, sizeof(visca_zoom_bytes), activeCamera, false, false, visca_response, CAM_MSG_ZOOM);
  }

  pt_stopped = pt_stopping;
  zoom_stopped = zoom_stopping;
}

void visca_set_memory(int pos) {
  visca_set_bytes[RECALL_NUM_BYTE] = byte(pos);
  visca_send("RECALL", visca_set_bytes, sizeof(visca_set_bytes), getActiveCamera());
}

void visca_recall_memory(int pos) {
  visca_recall_bytes[RECALL_NUM_BYTE] = byte(pos);
  // Serial.printf("in recall, active camera: %d previousCamera: %d\n", getActiveCamera()+1, previousCamera+1);
  visca_send("RECALL", visca_recall_bytes, sizeof(visca_recall_bytes), getActiveCamera());
}

void viscaSetup() {
  if (FirstTimeSetup) {
    // Config 9th camera
    settings.cameraIP[NUM_CAMERAS][0] = 255;
    settings.cameraIP[NUM_CAMERAS][1] = 255;
    settings.cameraIP[NUM_CAMERAS][2] = 255;
    settings.cameraIP[NUM_CAMERAS][3] = 255;
    settings.cameraPort[NUM_CAMERAS] = VISCA_PORT;
    settings.cameraType[NUM_CAMERAS] = CAM_VISCA;
    settings.cameraTransport[NUM_CAMERAS] = CAM_UDP;
    settings.cameraHeaders[NUM_CAMERAS] = 1;

    for (int i = 0; i < NUM_CAMERAS; i++) {
      settings.cameraPort[i] = 52381;
      settings.cameraHeaders[i] = 1;
    }
  }
}

// VISCA health probe: ask the camera for its power state. The common NA checks
// (network down / no IP) are handled one level up in cameraStatus().
int viscaStatus(int cameraNumber) {
  byte response[256];

  int pwrByte = VISCA_HEADER_SIZE + VISCA_PWR_INQ_BYTE;
  if (!settings.cameraHeaders[cameraNumber]) {
    pwrByte -= VISCA_HEADER_SIZE;
  }
  visca_send("PWR_INQ", visca_pwr_inq_bytes, sizeof(visca_pwr_inq_bytes), cameraNumber, true, true, response);

  if (response[pwrByte] == 0x02) {
    return CAMERA_UP;
  } else if (response[pwrByte] == 0x03) {
    return CAMERA_OFF; // Do something different? camera is there but on standy
  } else {
    return CAMERA_DOWN; // camera didn't response
  }
}

// Pull a "NAME:xxxx" value out of a VISCA discovery reply into out[cap].
// Falls back to "VISCA Camera" when the reply carries no name.
static void parseViscaName(const byte *resp, int len, char *out, size_t cap) {
  strlcpy(out, "VISCA Camera", cap);
  for (int i = 0; i + 5 < len; i++) {
    if (memcmp(resp + i, "NAME:", 5) == 0) {
      int s = i + 5, e = s;
      while (e < len && resp[e] >= 0x20 && resp[e] != 0xFF) e++;
      int n = e - s;
      if (n > 0) { if (n > (int)cap - 1) n = cap - 1; memcpy(out, resp + s, n); out[n] = 0; }
      return;
    }
  }
}

// VISCA discovery: broadcast the network inquiry and collect replies. Each
// reply's source ip:port identifies a camera. Appends to discoveredCameras[].
int discoverCameras() {
  byte response[256];
  int startPos = 0;
  int sendSize = sizeof(visca_net_inq_bytes);

  memset(response, 0, sizeof(response));
  if (!settings.cameraHeaders[CAMERA_BROADCAST]) {
    startPos = VISCA_HEADER_SIZE;
    sendSize -= VISCA_HEADER_SIZE;
  }

  logi("VISCA discovery: broadcasting network inquiry");

  camConnect(CAMERA_BROADCAST);
  camSend(CAMERA_BROADCAST, &visca_net_inq_bytes[startPos], sendSize);

  int found = 0;
  int len = 0;
  while (0 < (len = camRecv(CAMERA_BROADCAST, response, sizeof(response)))) {
    IPAddress ip = camRemoteIP(CAMERA_BROADCAST);
    uint16_t port = camRemotePort(CAMERA_BROADCAST);
    if (port == 0) port = VISCA_PORT;
    char name[24];
    parseViscaName(response, len, name, sizeof(name));
    if (addDiscovered(ip, port, CAM_VISCA, CAM_UDP, 1, name)) {   // broadcast reply = framed VISCA-over-IP
      logi("VISCA camera: %s:%u \"%s\"", ip.toString().c_str(), port, name);
      found++;
    }
  }
  logi("VISCA discovery found %d camera(s)", found);
  return found;
}
