paulkilroy/ChurchCam/src/Web.cpp

#include <PsychicHttp.h>
#include <TemplatePrinter.h>

#include <WiFi.h>
#include <EEPROM.h>
#include <Update.h>
#include <ESPmDNS.h>
#include <HTTPClient.h>
#include <WiFiClientSecure.h>
#include <ArduinoJson.h>

#include "globals.h"

// One async PsychicHttp server on port 80 serves both the HTTP config UI and the
// joystick/PTZ telemetry WebSocket (/ws) -- replacing the old synchronous Arduino
// WebServer plus the separate mWebSockets server on port 3000.
static PsychicHttpServer server;
static PsychicWebSocketHandler ptzWs;

// Web assets embedded into flash via board_build.embed_txtfiles / embed_files
// (platformio.ini). objcopy names the symbols _binary_html_<name>_start/_end,
// which we alias to friendly names here. The HTML templates come from
// embed_txtfiles so they are null-terminated (safe to print as C strings);
// the css/js are pre-gzipped raw binaries, so we serve them by [start,end).
extern const char config_html[]  asm("_binary_html_config_html_start");
extern const char restart_html[] asm("_binary_html_restart_html_start");

extern const uint8_t bootstrap_css_gz[]     asm("_binary_html_bootstrap_min_css_gz_start");
extern const uint8_t bootstrap_css_gz_end[] asm("_binary_html_bootstrap_min_css_gz_end");
extern const uint8_t bootstrap_js_gz[]      asm("_binary_html_bootstrap_bundle_min_js_gz_start");
extern const uint8_t bootstrap_js_gz_end[]  asm("_binary_html_bootstrap_bundle_min_js_gz_end");
extern const uint8_t headers_css_gz[]       asm("_binary_html_headers_css_gz_start");
extern const uint8_t headers_css_gz_end[]   asm("_binary_html_headers_css_gz_end");
extern const uint8_t validate_js_gz[]       asm("_binary_html_validate_forms_js_gz_start");
extern const uint8_t validate_js_gz_end[]   asm("_binary_html_validate_forms_js_gz_end");

// handleLogData lives in Logging.cpp (it owns the log ring buffer).
esp_err_t handleLogData(PsychicRequest* request, PsychicResponse* response);

String RestartMsg = "";
bool Restart = false;
volatile bool g_otaActive = false;      // set while an OTA upload is streaming (display OTA screen)
volatile uint32_t g_otaBytes = 0;
volatile uint32_t g_otaLastChunk = 0;   // millis() of the last chunk, for stuck-upload detection
volatile bool g_otaUrlMode = false;     // true during a GitHub pull-OTA (stall-abort stands down)
volatile bool g_calibrateCenter = false;   // request: capture joystick rest center (done in the control loop)

String processor(const String& var) {
  String serverVars = "";

  //Serial.printf("Processor replace: %s\n", var.c_str());
  if ( var == "Networks" ) {
    //      { "name": "Ethernet", "status": "off", "ip": "10.0.4.40", "info": "tbd" },
    const char nfmt[] = "{ \"name\": \"%s\", \"status\": \"%s\", \"ip\": \"%s\", \"ssid\": \"%s\", \"info\": \"%s\" },\n";
    char network[150];

    String status = "";
    status = ETH.started() ? "down" : "off";
    if ( ETH.hasIP() ) status = "up";
    sprintf(network, nfmt, "Ethernet", status.c_str(),
      status == "up" ? ETH.localIP().toString().c_str() : "-",
      "-",
      "");
    serverVars += network;

    status = WiFi.STA.started() ? "down" : "off";
    if ( WiFi.STA.hasIP() ) status = "up";
    // When Ethernet is the live uplink, a not-connected WiFi isn't a fault -- show it
    // as idle/off (neutral) rather than a red "down".
    if ( status == "down" && ETH.hasIP() ) status = "off";
    sprintf(network, nfmt, "WiFi", status.c_str(),
      status == "up" ? WiFi.localIP().toString().c_str() : "-",
      getSSID().c_str(),
      ( String(WiFi.RSSI()) + " dBm" ).c_str());
    serverVars += network;
    //Serial.printf("WiFi.getTxPower() %d\n", WiFi.getTxPower());

    status = WiFi.AP.started() ? "up" : "off";
    sprintf(network, nfmt, "Hotspot", status.c_str(),
      status == "up" ? WiFi.softAPIP().toString().c_str() : "-",
      AP_SSID,
      "");
    serverVars += network;
    return serverVars;
  } else if ( var == "ATEMSwitcher" ) {
    //       { "status": "down", "name": "ATEM Mini Pro", "ip": "10.0.4.40", "port": "-", "protocol": "1" },
    const char afmt[] = "{ \"status\": \"%s\", \"name\": \"%s\", \"ip\": \"%s\", \"port\": \"%s\", \"protocol\": \"%s\" }\n";
    char input[150];
    String name = atemSwitcher.getATEMmodelname();
    if ( name == "" ) name = "ATEM Switcher";
    sprintf(input, afmt, atemSwitcher.isConnected() ? "up" : "down",
      name.c_str(),
      settings.switcherIP.toString().c_str(),
      "-",
      "1");
    serverVars += input;
    return serverVars;
  } else if ( var == "ATEMCameras" ) {
    //       { "id": "0", "status": "down", "name": "Camera 1", "ip": "10.0.4.40", "port": "5678", "type": "0", "transport": "1", "headers": "0" },
    const char cfmt[] = "{ \"id\": \"%d\", \"status\": \"%s\", \"name\": \"%s\", \"ip\": \"%s\", \"port\": \"%d\", \"type\": \"%d\", \"transport\": \"%d\", \"headers\": \"%d\", \"user\": \"%s\" },\n";
    int cameraNumber = 0;
    for ( uint16_t i = 0; i < NUM_CAMERAS; i++ ) {
      // Controller camera slot i maps to ATEM video-source i+1 (getActiveCamera():
      // slot = videoSource - 1; video-source 1 = Input 1 = "CAM1"). Every ATEM
      // lookup below must use the video-source, not the 0-based slot, or the input
      // name/type lands one camera off.
      uint16_t videoSource = i + 1;
      // If no switcher than show all potential inputs...
      if ( atemSwitcher.isConnected() && !atemSwitcher.isInputInitialized(videoSource) )
        continue;
      // 0 is an external port input on the ATEM - thats what we want
      if ( atemSwitcher.isConnected() && atemSwitcher.getInputPortType(videoSource) != 0 )
        continue;

      int s = cachedCameraStatus(cameraNumber);   // cache filled by the main loop; no I/O here
      String status = "na";
      if ( s == CAMERA_UP ) status = "up";
      if ( s == CAMERA_DOWN ) status = "down";
      if ( s == CAMERA_OFF ) status = "off";

      String camName = atemSwitcher.getInputShortName(videoSource);
      if ( camName == "" ) camName = "Camera " + String(i + 1);   // 1-based, matches the controller camera number
      char input[220];
      // Options for camera status
      //    -compute status from responses(?) or just last response
      //  * -explicit status on page generation (way it was working)
      //    -status in background via ajax (regular polling of networks/atem/cameras)
      //    -status via "update status" ajax button on webpage
      //    Either way don't for get to backout status for non cameras (H2R/AV PC)
      //    i.e. cameras with no IP addresses
      sprintf(input, cfmt, cameraNumber, status.c_str(),
        camName.c_str(),
        settings.cameraIP[cameraNumber].toString().c_str(),
        settings.cameraPort[cameraNumber],
        settings.cameraType[cameraNumber],
        settings.cameraTransport[cameraNumber],
        settings.cameraHeaders[cameraNumber],
        settings.cameraUser[cameraNumber]);
      cameraNumber++;
      serverVars += input;
    }
    return serverVars;
  } else if ( var == "STATIC_IP" ) return settings.staticIP ? "checked" : "";
  else if ( var == "STATIC_IP_ADDR" ) return settings.staticIPAddr.toString();
  else if ( var == "STATIC_SUBNET_MASK" ) return settings.staticSubnetMask.toString();
  else if ( var == "STATIC_GATEWAY" ) return settings.staticGateway.toString();
  else if ( var == "ATEM_IP_ADDR" ) return settings.switcherIP.toString();
  else if ( var == "SSID" ) return getSSID();
  else if ( var == "PSK" ) return getPSK();
  else if ( var == "PAN_MID" )  return String(settings.panMid);
  else if ( var == "TILT_MID" ) return String(settings.tiltMid);
  else if ( var == "ZOOM_MID" ) return String(settings.zoomMid);
  else if ( var == "BOARD_NAME" ) return Pinouts[HWRev].name;
  else if ( var == "FW_VERSION" ) return String(FW_VERSION);
  else if ( var == "RESTART_MSG" ) return RestartMsg;
  // Wrong-board banner: empty on a healthy WROVER-E, a loud red alert otherwise.
  else if ( var == "BOARD_ALERT" ) {
    if ( PsramOk ) return String();
    return String(
      "<div class=\"alert alert-danger\" role=\"alert\">"
      "<b>&#9888;&#65039; Wrong board &mdash; no PSRAM detected.</b> "
      "This firmware requires a <b>WROVER-E</b> module. On this board it will run "
      "low on memory and crash, and Ethernet may not work. Reflash a WROVER-E "
      "(or build without <code>-DBOARD_HAS_PSRAM</code> for a WROOM-32UE)."
      "</div>");
  }
  // Discovered cameras start empty on page load; the list is filled client-side
  // by the /discoverCameras AJAX call when the user clicks "Discover Cameras".
  else if ( var == "DiscoveredCameras" ) return String();

  logi("Unknown replace: %s\n", var.c_str());
  return String();
}

// ---------------------------------------------------------------------------
// Response helpers
// ---------------------------------------------------------------------------

// Broadcast one telemetry frame to every connected /ws client. Called from the
// camera-control loop; keeps PsychicHttp types out of Controller.cpp.
//
// Threading: telemetry is generated on the Arduino loop task, but PsychicHttp adds
// clients (on connect) and FREES them (on disconnect) on the HTTP server task.
// Walking that client list with sendAll() from the loop task races those frees and
// dereferences a dangling client -> LoadProhibited crash. Fix: hand the frame to the
// server task via httpd_queue_work(), so sendAll() runs in the same context that
// mutates the list -- no lock, no race. The frame is heap-copied and freed by the
// worker. wsClients (kept in onOpen/onClose, also on the server task) lets us skip
// the copy+queue when nobody is listening.
static volatile int wsClients = 0;

static void telemetryWork(void* arg) {          // runs on the HTTP server task
  char* buf = (char*)arg;
  ptzWs.sendAll(HTTPD_WS_TYPE_TEXT, buf, strlen(buf));
  free(buf);
}

void broadcastTelemetry(const char* msg) {
  if (wsClients <= 0 || server.server == NULL) return;   // nobody listening / server down
  char* buf = strdup(msg);                               // small (<256B), freed in worker
  if (!buf) return;                                      // out of heap: drop this frame
  if (httpd_queue_work(server.server, telemetryWork, buf) != ESP_OK)
    free(buf);                                           // queue full: drop, don't leak
}

// Stream a flash-embedded HTML template through PsychicHttp's TemplatePrinter,
// substituting %VAR% via processor(). Streamed in chunks -- no giant heap String
// (this is what removes the multi-second config-page stall). Every literal % in
// config.html is followed by a non-parameter char, so TemplatePrinter re-emits
// them verbatim -- no escaping step needed now that the file is embedded raw.
static esp_err_t sendTemplate(PsychicResponse* response, const char* embeddedHtml) {
  PsychicStreamResponse stream(response, "text/html");
  stream.beginSend();
  TemplatePrinter::start(stream,
    [](Print& out, const char* param) -> bool {
      out.print(processor(String(param)));   // unknown -> "" (consumed), matches old behavior
      return true;
    },
    [embeddedHtml](TemplatePrinter& printer) {
      printer.print(embeddedHtml);   // embedded flash is memory-mapped; read directly
    });
  return stream.endSend();
}

// Serve a gzipped, long-cached static asset embedded in flash.
static esp_err_t sendGzipAsset(PsychicResponse* response, const char* type,
                               const uint8_t* data, size_t len) {
  response->addHeader("Cache-Control", "public, max-age=2678400");
  response->addHeader("Content-Encoding", "gzip");
  return response->send(200, type, data, len);
}

// ---------------------------------------------------------------------------
// HTTP handlers
// ---------------------------------------------------------------------------

static esp_err_t handleRoot(PsychicRequest* request, PsychicResponse* response) {
  logi("web request for: %s\n", request->uri().c_str());
  return sendTemplate(response, config_html);
}

static esp_err_t handleRestartAndWait(PsychicRequest* request, PsychicResponse* response) {
  if ( RestartMsg == "" ) RestartMsg = "Restart Successful.";
  Serial.println("RESTART - Sending HTML");
  esp_err_t r = sendTemplate(response, restart_html);
  Restart = true;   // the main loop performs the actual reboot
  return r;
}

static esp_err_t handleDiscoverCameras(PsychicRequest* request, PsychicResponse* response) {
  logi("web request for: %s\n", request->uri().c_str());
  const char fmt[] = "{ \"id\": \"%d\", \"name\": \"%s\", \"ip\": \"%s\", \"port\": \"%u\", \"type\": \"%d\", \"transport\": \"%d\", \"headers\": \"%d\" }";

  // Run both discovery mechanisms; each appends into discoveredCameras[],
  // de-duplicated by ip:port. (VISCA-TCP is not discoverable and stays manual.)
  resetDiscovered();
  discoverCameras();        // VISCA-UDP broadcast probe
  discoverOnvifCameras();   // ONVIF WS-Discovery

  String inputs = "[";
  for ( int i = 0; i < numDiscoveredCameras; ++i ) {
    DiscoveredCamera &c = discoveredCameras[i];
    if ( i > 0 ) inputs += ',';
    char input[170];
    sprintf(input, fmt, i, c.name, c.ip.toString().c_str(), c.port, c.type, c.transport, c.headers);
    inputs += input;
  }
  inputs += "]";
  logi("Discovered %d camera(s): %s", numDiscoveredCameras, inputs.c_str());
  return response->send(200, "application/json", inputs.c_str());
}

// One scan to find everything. The quick broadcast/multicast probes run first and
// synchronously (VISCA-over-IP UDP broadcast + ONVIF WS-Discovery), seeding the list;
// then the full subnet sweep (CameraScan.cpp) starts and runs in the main loop, one
// host per tick, appending the raw/TCP cameras that broadcast can't reach. The page
// polls /scanProgress for the bar + the growing found list (reused assign UI). A
// full setup runs this once, so the ~minute it can take on a /24 is acceptable.
static esp_err_t handleScanSubnet(PsychicRequest* request, PsychicResponse* response) {
  logi("web request for: %s\n", request->uri().c_str());
  resetDiscovered();
  discoverCameras();        // VISCA-over-IP UDP broadcast (fast)
  discoverOnvifCameras();   // ONVIF WS-Discovery (fast)
  scanStart();              // full subnet sweep -- appends to the seeded list, de-duped
  char out[64];
  snprintf(out, sizeof out, "{\"ok\":true,\"total\":%u}", (unsigned)g_scanTotal);
  return response->send(200, "application/json", out);
}

static esp_err_t handleScanProgress(PsychicRequest* request, PsychicResponse* response) {
  String out = "{\"running\":";
  out += (g_scanRunning ? "true" : "false");
  out += ",\"scanned\":"; out += String((unsigned)g_scanDone);
  out += ",\"total\":";   out += String((unsigned)g_scanTotal);
  out += ",\"found\":[";
  for ( int i = 0; i < numDiscoveredCameras; ++i ) {
    DiscoveredCamera &c = discoveredCameras[i];
    if ( i > 0 ) out += ',';
    char e[180];
    snprintf(e, sizeof e,
      "{\"id\":\"%d\",\"name\":\"%s\",\"ip\":\"%s\",\"port\":\"%u\",\"type\":\"%d\",\"transport\":\"%d\",\"headers\":\"%d\"}",
      i, c.name, c.ip.toString().c_str(), c.port, c.type, c.transport, c.headers);
    out += e;
  }
  out += "]}";
  return response->send(200, "application/json", out.c_str());
}

// Discover Blackmagic ATEM switchers on the LAN via mDNS. Blackmagic renamed the
// service -- current units advertise _switcher_ctrl._udp, older/other ones used
// _blackmagic._tcp -- so query BOTH and merge. Returns a JSON array so the config
// page can offer to fill in the ATEM IP. Read-only -- does not change settings.
static esp_err_t handleDiscoverATEM(PsychicRequest* request, PsychicResponse* response) {
  logi("web request for: %s\n", request->uri().c_str());
  String out = "[";
  bool first = true;
  const char* svcs[][2] = { { "switcher_ctrl", "udp" }, { "blackmagic", "tcp" } };
  for ( auto& svc : svcs ) {
    int n = MDNS.queryService(svc[0], svc[1]);
    for ( int i = 0; i < n; ++i ) {
      if ( !first ) out += ',';
      first = false;
      char e[160];
      snprintf(e, sizeof e, "{\"name\":\"%s\",\"ip\":\"%s\",\"port\":%u}",
               MDNS.hostname(i).c_str(), MDNS.address(i).toString().c_str(), MDNS.port(i));
      out += e;
    }
  }
  out += "]";
  logi("ATEM discovery: %s", out.c_str());
  return response->send(200, "application/json", out.c_str());
}

// Save new settings from client into EEPROM and restart. Fields are read by name
// (getParam returns null when a field wasn't submitted, so only present values
// change), and the per-camera fields are queried by index.
static esp_err_t handleSave(PsychicRequest* request, PsychicResponse* response) {
  logi("SAVE request for: %s\n", request->uri().c_str());

  PsychicWebParameter* p;
  if ( (p = request->getParam("networkName")) )     strlcpy(settings.ssid, p->value().c_str(), sizeof(settings.ssid));
  if ( (p = request->getParam("networkPassword")) ) strlcpy(settings.psk,  p->value().c_str(), sizeof(settings.psk));
  if ( (p = request->getParam("staticIP")) )        settings.staticIP = ( p->value() == "true" );
  if ( (p = request->getParam("staticIPAddr")) )    settings.staticIPAddr.fromString(p->value());
  if ( (p = request->getParam("staticSubnetMask")) ) settings.staticSubnetMask.fromString(p->value());
  if ( (p = request->getParam("staticGateway")) )   settings.staticGateway.fromString(p->value());
  if ( (p = request->getParam("atemConfigIP")) )    settings.switcherIP.fromString(p->value());

  for ( int i = 0; i < NUM_CAMERAS; i++ ) {
    String n = String(i);
    if ( (p = request->getParam(("camConfigIP" + n).c_str())) )        settings.cameraIP[i].fromString(p->value());
    // One preset selects VISCA dialect + transport + framing:
    //   0 Sony VISCA-over-IP (UDP, framed)   1 PTZOptics (TCP, raw)
    //   2 HuddleCam (UDP, raw)               3 ONVIF (TCP)
    if ( (p = request->getParam(("camConfigProto" + n).c_str())) ) {
      switch ( p->value().toInt() ) {
        case 1:  settings.cameraType[i]=CAM_VISCA; settings.cameraTransport[i]=CAM_TCP; settings.cameraHeaders[i]=0; break;
        case 2:  settings.cameraType[i]=CAM_VISCA; settings.cameraTransport[i]=CAM_UDP; settings.cameraHeaders[i]=0; break;
        case 3:  settings.cameraType[i]=CAM_ONVIF; settings.cameraTransport[i]=CAM_TCP; settings.cameraHeaders[i]=1; break;
        default: settings.cameraType[i]=CAM_VISCA; settings.cameraTransport[i]=CAM_UDP; settings.cameraHeaders[i]=1; break; // Sony
      }
    }
    if ( (p = request->getParam(("camConfigPort" + n).c_str())) )      settings.cameraPort[i]      = p->value().toInt();
    if ( (p = request->getParam(("camConfigUser" + n).c_str())) )      strlcpy(settings.cameraUser[i], p->value().c_str(), sizeof(settings.cameraUser[i]));
    // Password is only echoed as blank, so an empty field means "keep existing".
    if ( (p = request->getParam(("camConfigPass" + n).c_str())) && p->value().length() )
                                                                       strlcpy(settings.cameraPass[i], p->value().c_str(), sizeof(settings.cameraPass[i]));
  }

  if ( !InSimulator ) {
    settings.magic = SETTINGS_MAGIC;
    settings.version = SETTINGS_VERSION;
    EEPROM.put(0, settings);
    EEPROM.commit();
  }

  RestartMsg = "Successfully updated settings.";
  return handleRestartAndWait(request, response);
}

static esp_err_t handleErase(PsychicRequest* request, PsychicResponse* response) {
  for ( size_t i = 0; i < sizeof(settings); i++ ) EEPROM.write(i, 255);
  EEPROM.commit();
  RestartMsg = "All Data Erased.";
  return handleRestartAndWait(request, response);
}

// Scan for nearby WiFi APs (2.4 GHz only -- the ESP32 can't see 5 GHz) and return
// them as JSON [{ssid, rssi, secure}]. Blocking (~2-4s); called from the config AP,
// where it briefly hops channels but the AP client reconnects. Lets the operator
// pick an SSID from a list instead of typing one that comes back NO_AP_FOUND.
static esp_err_t handleScanWifi(PsychicRequest* request, PsychicResponse* response) {
  int n = WiFi.scanNetworks();
  String json = "[";
  for ( int i = 0; i < n; i++ ) {
    String ssid = WiFi.SSID(i);
    ssid.replace("\\", "\\\\");
    ssid.replace("\"", "\\\"");
    if ( i ) json += ",";
    json += "{\"ssid\":\"" + ssid + "\",\"rssi\":" + String(WiFi.RSSI(i)) +
            ",\"secure\":" + ( WiFi.encryptionType(i) == WIFI_AUTH_OPEN ? "false" : "true" ) + "}";
  }
  json += "]";
  WiFi.scanDelete();
  return response->send(200, "application/json", json.c_str());
}

// Recalibrate the joystick's resting center. The control loop (which owns the ADC)
// does the capture; we flag it, wait for it to clear, then return the new centers.
static esp_err_t handleCalibrateCenter(PsychicRequest* request, PsychicResponse* response) {
  g_calibrateCenter = true;
  uint32_t t0 = millis();
  while ( g_calibrateCenter && millis() - t0 < 800 ) delay(10);
  char json[96];
  snprintf(json, sizeof json, "{\"panMid\":%u,\"tiltMid\":%u,\"zoomMid\":%u}",
           settings.panMid, settings.tiltMid, settings.zoomMid);
  return response->send(200, "application/json", json);
}

static esp_err_t handleNotFound(PsychicRequest* request, PsychicResponse* response) {
  logi("web request for: %s\n", request->uri().c_str());
  // Captive portal: while we're only reachable on our own hotspot, bounce every
  // unknown URL -- including the OS connectivity probes (captive.apple.com,
  // connectivitycheck.gstatic.com, /generate_204, ...) -- to the config page so a
  // phone or laptop pops it open automatically on join. Paired with the DNS
  // responder in Network.cpp that points every hostname at the AP IP.
  if ( hotspotUp() ) {
    String loc = "http://" + WiFi.softAPIP().toString() + "/";
    return response->redirect(loc.c_str());
  }
  return response->send(404, "text/html", "<!DOCTYPE html><html><head><meta charset=\"ASCII\"><meta name=\"viewport\"content=\"width=device-width, initial-scale=1.0\"><title>PTZ Setup</title></head><body style=\"font-family:Verdana;\"><table bgcolor=\"#777777\"border=\"0\"width=\"100%\"cellpadding=\"1\"style=\"color:#ffffff;font-size:.8em;\"><tr><td><h1>&nbsp PTZ Setup</h1></td></tr></table><br>404 - Page not found</body></html>");
}

// OTA firmware upload: chunked write to Update, then the client polls /restart.
static esp_err_t otaUploadChunk(PsychicRequest* request, const String& filename,
                                uint64_t index, uint8_t* data, size_t len, bool last) {
  g_otaLastChunk = millis();
  if ( index == 0 ) {
    Serial.printf("UPDATE: %s\n", filename.c_str());
    if ( !Update.begin(UPDATE_SIZE_UNKNOWN) ) {
      Update.printError(Serial);
      g_otaActive = false;      // never took over the display; release it
      return ESP_FAIL;          // don't stream the rest of the image into a failed session
    }
    g_otaActive = true;         // the display takes over with the "do not power off" screen
  }
  if ( !g_otaActive ) return ESP_FAIL;   // begin() failed on chunk 0; refuse the remaining chunks
  if ( len && Update.write(data, len) != len ) Update.printError(Serial);
  g_otaBytes = index + len;
  if ( last ) {
    if ( Update.end(true) ) Serial.printf("Update Success: %llu\n", index + len);
    else Update.printError(Serial);
    g_otaActive = false;        // upload finished; /restart reboots, but release the display now
  }
  return ESP_OK;
}

// ---------------------------------------------------------------------------
// GitHub OTA: pull the latest published release over HTTPS
// ---------------------------------------------------------------------------
// Structured after the EllaFi project: the GitHub Release is the source of truth,
// queried live via the API (server-side, so the browser's CORS block doesn't
// apply), and a background FreeRTOS task streams the firmware asset straight into
// the OTA partition. ChurchCam differs from EllaFi only in versioning -- it has no
// build-number scheme, so the release *tag* (git describe, e.g. v1.2.0) is the
// version and the asset is plain firmware.bin, compared against FW_VERSION as
// semver. NOTE: setInsecure() skips TLS cert validation (a MITM could serve a
// forged image) -- acceptable for a LAN admin action pulling from a public repo;
// a signed image would be the real fix. GitHub's API needs a User-Agent or 403s.
static const char* GITHUB_RELEASES_API =
  "https://api.github.com/repos/paulkilroy/ChurchCam/releases/latest";

struct LatestRelease { String tag; String url; String err; };

static LatestRelease fetchLatestRelease() {
  LatestRelease r;
  WiFiClientSecure wc; wc.setInsecure(); wc.setTimeout(12000);
  HTTPClient http; http.setTimeout(12000);
  http.setFollowRedirects(HTTPC_STRICT_FOLLOW_REDIRECTS);
  if (!http.begin(wc, GITHUB_RELEASES_API)) { r.err = "connect failed"; return r; }
  http.addHeader("User-Agent", "ChurchCam-OTA");          // required by the GitHub API
  http.addHeader("Accept", "application/vnd.github+json");
  int code = http.GET();
  if (code != 200) {
    r.err = (code == 404) ? "no releases published yet" : ("HTTP " + String(code));
    http.end();
    return r;
  }
  String body = http.getString();
  http.end();
  // Filter the (large) release JSON down to just what we need before parsing.
  JsonDocument filter;
  filter["tag_name"] = true;
  filter["assets"][0]["name"] = true;
  filter["assets"][0]["browser_download_url"] = true;
  JsonDocument doc;
  if (deserializeJson(doc, body, DeserializationOption::Filter(filter))) { r.err = "parse error"; return r; }
  r.tag = doc["tag_name"].as<String>();
  for (JsonObject a : doc["assets"].as<JsonArray>()) {
    String name = a["name"].as<String>();
    if (name.endsWith(".bin")) {
      r.url = a["browser_download_url"].as<String>();
      if (name == "firmware.bin") break;   // prefer the plain name; otherwise first .bin wins
    }
  }
  if (r.url.isEmpty() && r.err.isEmpty()) r.err = "no firmware.bin asset in latest release";
  return r;
}

// Parse a git-describe/semver tag ("v1.2.3", "1.2", "v2.0.0-3-gabc1234") into a
// comparable {major,minor,patch}. Returns false if it doesn't begin with a version
// number -- e.g. an untagged dev build, which is just a short commit hash.
static bool parseSemver(const String& s, long v[3]) {
  v[0] = v[1] = v[2] = 0;
  int i = 0;
  if (i < (int)s.length() && (s[i] == 'v' || s[i] == 'V')) i++;
  if (i >= (int)s.length() || !isdigit((unsigned char)s[i])) return false;
  int part = 0;
  for (; i < (int)s.length() && part < 3; i++) {
    char c = s[i];
    if (isdigit((unsigned char)c)) v[part] = v[part] * 10 + (c - '0');
    else if (c == '.') part++;
    else break;   // stop at the '-' git-describe suffix or anything non-numeric
  }
  return true;
}

// latest strictly newer than current? Only true when BOTH parse as real versions,
// so an untagged dev build never falsely reports "update available".
static bool isNewerVersion(const String& latest, const String& current) {
  long a[3], b[3];
  if (!parseSemver(latest, a) || !parseSemver(current, b)) return false;
  for (int i = 0; i < 3; i++) if (a[i] != b[i]) return a[i] > b[i];
  return false;
}

// Stream firmware.bin from a URL straight into the OTA partition. Runs on the OTA
// task (below); drives g_otaBytes/g_otaLastChunk so the display's "updating" screen
// tracks progress and webLoop's stall-abort stays satisfied.
static bool flashFirmwareFromUrl(const String& url, size_t& written, String& err) {
  WiFiClientSecure wc; wc.setInsecure(); wc.setTimeout(20000);
  HTTPClient http; http.setTimeout(60000);
  http.setFollowRedirects(HTTPC_STRICT_FOLLOW_REDIRECTS);   // GitHub assets 302 to objects.githubusercontent.com
  if (!http.begin(wc, url)) { err = "connect failed"; return false; }
  int code = http.GET();
  if (code != 200) { err = "HTTP " + String(code); http.end(); return false; }
  int total = http.getSize();
  if (total <= 0) { err = "unknown content length"; http.end(); return false; }
  if (!Update.begin(total, U_FLASH)) { err = Update.errorString(); http.end(); return false; }
  WiFiClient* stream = http.getStreamPtr();
  uint8_t buf[1024];
  int remaining = total;
  unsigned long lastData = millis();
  while (http.connected() && remaining > 0) {
    int avail = stream->available();
    if (avail > 0) {
      int n = stream->readBytes(buf, min(avail, (int)sizeof(buf)));
      if (n > 0) {
        Update.write(buf, n);
        remaining -= n;
        lastData = millis();
        g_otaBytes = (uint32_t)(total - remaining);
        g_otaLastChunk = millis();
      }
    } else if (millis() - lastData > 10000) {
      err = "download stalled"; http.end(); Update.abort(); return false;
    } else {
      delay(1);
    }
  }
  http.end();
  if (remaining > 0) { err = "incomplete (" + String(total - remaining) + "/" + String(total) + ")"; Update.abort(); return false; }
  if (!Update.end(true)) { err = Update.errorString(); return false; }
  written = total;
  return true;
}

// The pull-and-flash itself, on its own task so it doesn't tie up the one HTTP
// worker (TLS + a ~1.4 MB download takes several seconds). g_otaUrlMode tells
// webLoop's stall-abort to stand down, since we -- not the upload handler -- own
// the Update session here.
static void githubOtaTask(void*) {
  g_otaActive = true; g_otaUrlMode = true; g_otaBytes = 0; g_otaLastChunk = millis();
  LatestRelease rel = fetchLatestRelease();
  if (rel.url.isEmpty()) {
    loge("GitHub OTA: %s", rel.err.length() ? rel.err.c_str() : "no asset URL");
    g_otaActive = false; g_otaUrlMode = false;
    vTaskDelete(NULL); return;
  }
  logi("GitHub OTA: downloading %s from %s", rel.tag.c_str(), rel.url.c_str());
  size_t written = 0;
  String err;
  if (flashFirmwareFromUrl(rel.url, written, err)) {
    logi("GitHub OTA: flashed %u bytes -- rebooting", (unsigned)written);
    delay(1500);
    esp_restart();
  }
  loge("GitHub OTA failed: %s", err.c_str());
  g_otaActive = false; g_otaUrlMode = false;
  vTaskDelete(NULL);
}

// GET /checkUpdate -> query GitHub for the latest release and compare to this build.
static esp_err_t handleCheckUpdate(PsychicRequest* request, PsychicResponse* response) {
  logi("web request for: %s\n", request->uri().c_str());
  LatestRelease rel = fetchLatestRelease();
  JsonDocument out;
  out["current"]         = String(FW_VERSION);
  out["latest"]          = rel.tag;
  out["canInstall"]      = !rel.url.isEmpty();
  out["updateAvailable"] = (!rel.url.isEmpty()) && isNewerVersion(rel.tag, String(FW_VERSION));
  if (rel.err.length()) out["error"] = rel.err;
  String s; serializeJson(out, s);
  response->addHeader("Cache-Control", "no-store");
  return response->send(200, "application/json", s.c_str());
}

// POST /updateFromGithub -> kick off the pull-and-flash in the background. The page
// then shows the OTA screen and polls /restart, same as a manual .bin upload.
static esp_err_t handleUpdateFromGithub(PsychicRequest* request, PsychicResponse* response) {
  logi("web request for: %s\n", request->uri().c_str());
  if (g_otaActive) return response->send(409, "text/plain", "An update is already in progress");
  if (xTaskCreate(githubOtaTask, "GithubOTA", 16384, NULL, 5, NULL) != pdPASS)
    return response->send(500, "text/plain", "Could not start update");
  return response->send(200, "application/json", "{\"ok\":true}");
}

// ---------------------------------------------------------------------------
// Setup / loop
// ---------------------------------------------------------------------------

void webSetup() {
  server.config.max_uri_handlers = 24;   // headroom over the ~14 routes below

  server.on("/", HTTP_GET, handleRoot);

  server.on("/bootstrap.min.css", HTTP_GET, [](PsychicRequest* req, PsychicResponse* res) {
    return sendGzipAsset(res, "text/css", bootstrap_css_gz, bootstrap_css_gz_end - bootstrap_css_gz); });
  server.on("/headers.css", HTTP_GET, [](PsychicRequest* req, PsychicResponse* res) {
    return sendGzipAsset(res, "text/css", headers_css_gz, headers_css_gz_end - headers_css_gz); });
  server.on("/bootstrap.bundle.min.js", HTTP_GET, [](PsychicRequest* req, PsychicResponse* res) {
    return sendGzipAsset(res, "text/javascript", bootstrap_js_gz, bootstrap_js_gz_end - bootstrap_js_gz); });
  server.on("/validate-forms.js", HTTP_GET, [](PsychicRequest* req, PsychicResponse* res) {
    return sendGzipAsset(res, "text/javascript", validate_js_gz, validate_js_gz_end - validate_js_gz); });

  server.on("/ping", HTTP_GET, [](PsychicRequest* req, PsychicResponse* res) {
    return res->send(200, "text/plain", "pong"); });

  server.on("/discoverCameras", HTTP_GET, handleDiscoverCameras);
  server.on("/discoverATEM", HTTP_GET, handleDiscoverATEM);
  server.on("/scanSubnet", HTTP_GET, handleScanSubnet);
  server.on("/scanProgress", HTTP_GET, handleScanProgress);
  server.on("/save", HTTP_POST, handleSave);
  server.on("/restart", HTTP_ANY, handleRestartAndWait);
  server.on("/logData", HTTP_GET, handleLogData);
  server.on("/erase", HTTP_GET, handleErase);
  server.on("/scanWifi", HTTP_GET, handleScanWifi);
  server.on("/calibrateCenter", HTTP_GET, handleCalibrateCenter);
  server.on("/checkUpdate", HTTP_GET, handleCheckUpdate);
  server.on("/updateFromGithub", HTTP_POST, handleUpdateFromGithub);

  // OTA firmware upload
  PsychicUploadHandler* updateHandler = new PsychicUploadHandler();
  updateHandler->onUpload(otaUploadChunk);
  updateHandler->onRequest([](PsychicRequest* req, PsychicResponse* res) {
    RestartMsg = String("Firmware Update: ") + ( Update.hasError() ? "FAIL" : "OK" ) + ".";
    // The client's JS calls /restart next, which performs the reboot.
    return res->send(200, "text/plain", "pong");
  });
  server.on("/update", HTTP_POST, updateHandler);

  // Joystick / PTZ telemetry WebSocket, on the same port 80 (was mWebSockets:3000).
  ptzWs.onOpen([](PsychicWebSocketClient* client) {
    wsClients++;   // maintained on the server task; gates broadcastTelemetry()
    logi("ws telemetry client connected: %s", client->remoteIP().toString().c_str()); });
  ptzWs.onClose([](PsychicWebSocketClient* client) {
    if (wsClients > 0) wsClients--;
    logi("ws telemetry client disconnected"); });
  ptzWs.onFrame([](PsychicWebSocketRequest* req, httpd_ws_frame_t* frame) -> esp_err_t {
    return ESP_OK;   // browser only receives telemetry; inbound frames ignored
  });
  server.on("/ws", &ptzWs);

  server.onNotFound(handleNotFound);
  server.begin();
}

void webLoop() {
  // /save, /erase and /restart set Restart from the async HTTP task; the actual
  // reboot must happen here in loop context. (This flag previously had no consumer,
  // so saving Wi-Fi settings persisted them to EEPROM but never rebooted -- the
  // device kept running in its boot-time mode and never reconnected.) The short
  // delay lets the HTTP response (the "restarting" page) flush to the browser.
  if ( Restart ) {
    logi("Restart requested -- rebooting to apply settings");
    delay(400);
    ESP.restart();
  }

  // PsychicHttp serves requests in its own FreeRTOS task, so there is normally
  // nothing to poll here. The one exception: if an OTA upload dies mid-stream
  // (dropped client, network glitch), the upload callback stops firing and
  // g_otaActive would otherwise stay latched forever, wedging the display on the
  // "do not power off" screen. Detect the stall here and abort the update.
  #define OTA_STALL_MS 15000
  // Skip during a GitHub pull-OTA: that path owns its own Update session on the OTA
  // task and does its own stall detection; aborting it here would corrupt the flash.
  if ( g_otaActive && !g_otaUrlMode && ( millis() - g_otaLastChunk > OTA_STALL_MS ) ) {
    logw("OTA upload stalled (%lu ms with no data); aborting", millis() - g_otaLastChunk);
    Update.abort();
    g_otaActive = false;
  }
}
