paulkilroy/ChurchCam/src/Onvif.cpp

#include "globals.h"
#include <string.h>
#include <time.h>
#include <lwip/sockets.h>
#include <errno.h>
#include <esp_random.h>
#include <mbedtls/sha1.h>
#include <mbedtls/base64.h>

// https://blog.devmobile.co.nz/2021/08/26/security-camera-onvif-discovery/

// https://www.onvif.org/onvif/ver20/ptz/wsdl/ptz.wsdl

// https://github.com/MikhaelMIEM/Visca-Onvif-converter-server

// From https://specs.xmlsoap.org/ws/2005/04/discovery/ws-discovery.pdf & http://www.onvif.org/wp-content/uploads/2016/12/ONVIF_WG-APG-Application_Programmers_Guide-1.pdf
/*
char WSDiscoveryProbeMessages[] =
"<?xml version = \"1.0\" encoding=\"UTF-8\"?>" 
"<e:Envelope xmlns:e=\"http://www.w3.org/2003/05/soap-envelope\" " 
        "xmlns:w=\"http://schemas.xmlsoap.org/ws/2004/08/addressing\" " 
        "xmlns:d=\"http://schemas.xmlsoap.org/ws/2005/04/discovery\" " 
        "xmlns:dn=\"http://www.onvif.org/ver10/network/wsdl\"> " 
    "<e:Header>"
        "<w:MessageID>"
            "dae35c8e-97df-49a5-9fc3-d0bcad1db922"
        "</w:MessageID>" 
        "<w:To e:mustUnderstand=\"true\">urn:schemas-xmlsoap-org:ws:2005:04:discovery</w:To> " 
        "<w:Action mustUnderstand=\"true\">http://schemas.xmlsoap.org/ws/2005/04/discovery/Probe</w:Action> " 
    "</e:Header> " 
    "<e:Body> " 
        "<d:Probe> " 
            "<d:Types>dn:NetworkVideoTransmitter</d:Types>" 
        "</d:Probe> " 
    "</e:Body> " 
"</e:Envelope>";
*/

// SOAP envelope, WS-Security header, and per-action bodies are kept separate so
// the security header (with a freshly computed digest) can be regenerated on
// every request. buildOnvifMessage() fills securityFormat, wraps it + a body in
// envelopeFormat, then wraps that in httpFormat.
//
// The <Password> is a WS-UsernameToken PasswordDigest:
//   digest = Base64( SHA1( nonceBytes + Created + password ) )
// with a random per-request nonce and a real UTC <Created> (needs NTP).
const char envelopeFormat[] =
"<s:Envelope xmlns:s=\"http://www.w3.org/2003/05/soap-envelope\">\r\n"
"<s:Header>\r\n"
"%s"                 // WS-Security header (securityFormat, already formatted)
"</s:Header>\r\n"
"<s:Body>\r\n"
"%s"                 // action body
"</s:Body>\r\n"
"</s:Envelope>\r\n";

const char securityFormat[] =
"<Security s:mustUnderstand=\"1\" xmlns=\"http://docs.oasis-open.org/wss/2004/01/oasis-200401-wss-wssecurity-secext-1.0.xsd\">\r\n"
"<UsernameToken>\r\n"
"<Username>%s</Username>\r\n"
"<Password Type=\"http://docs.oasis-open.org/wss/2004/01/oasis-200401-wss-username-token-profile-1.0#PasswordDigest\">%s</Password>\r\n"
"<Nonce EncodingType=\"http://docs.oasis-open.org/wss/2004/01/oasis-200401-wss-soap-message-security-1.0#Base64Binary\">%s</Nonce>\r\n"
"<Created xmlns=\"http://docs.oasis-open.org/wss/2004/01/oasis-200401-wss-wssecurity-utility-1.0.xsd\">%s</Created>\r\n"
"</UsernameToken>\r\n"
"</Security>\r\n";

// Action bodies (ProfileToken still hardcoded -- TODO: read it from the camera).
const char stopBody[] =
"<Stop xmlns=\"http://www.onvif.org/ver20/ptz/wsdl\">\r\n"
"<Zoom>%s</Zoom>\r\n"
"<ProfileToken>Profile_1</ProfileToken>\r\n"
"<PanTilt>%s</PanTilt>\r\n"
"</Stop>\r\n";

const char zoomBody[] =
"<ContinuousMove xmlns=\"http://www.onvif.org/ver20/ptz/wsdl\">\r\n"
"<ProfileToken>Profile_1</ProfileToken>\r\n"
"<Velocity>\r\n"
"<Zoom x=\"%1.2f\" xmlns=\"http://www.onvif.org/ver10/schema\">\r\n"
"</Zoom>\r\n"
"</Velocity>\r\n"
"</ContinuousMove>\r\n";

const char velBody[] =
"<ContinuousMove xmlns=\"http://www.onvif.org/ver20/ptz/wsdl\">\r\n"
"<ProfileToken>Profile_1</ProfileToken>\r\n"
"<Velocity>\r\n"
"<PanTilt xmlns=\"http://www.onvif.org/ver10/schema\" x=\"%1.3f\" y=\"%1.3f\"/>\r\n"
"</Velocity>\r\n"
"</ContinuousMove>\r\n";

const char setPresetBody[] =
"<SetPreset xmlns=\"http://www.onvif.org/ver20/ptz/wsdl\">\r\n"
"<ProfileToken>Profile_1</ProfileToken>\r\n"
"<PresetToken>%d</PresetToken>\r\n"
"</SetPreset>\r\n";

const char goToPresetBody[] =
"<GotoPreset xmlns=\"http://www.onvif.org/ver20/ptz/wsdl\">\r\n"
"<ProfileToken>Profile_1</ProfileToken>\r\n"
"<PresetToken>%d</PresetToken>\r\n"
"</GotoPreset>\r\n";

const char getPresetsBody[] =
"<GetPresets xmlns=\"http://www.onvif.org/ver20/ptz/wsdl\">\r\n"
"<ProfileToken>Profile_1</ProfileToken>\r\n"
"</GetPresets>\r\n";

const char httpFormat[] =
"POST /onvif/PTZ HTTP/1.1\r\n"
"Host: %d.%d.%d.%d\r\n"//Replace IP
"Accept: */*\r\n"
"User-Agent: curl/8.1.2\r\n"
"Connection: Keep-Alive\r\n"
"Content-Type: text/xml; charset=utf-8\r\n"
"Content-Length: %d\r\n"
"\r\n"
"%s";

char soapBuf[1800];
char messageBuf[2400];
char securityBuf[640];

int prevPan = 0, prevTilt = 0, prevZoom = 0;

// --- WS-Security digest helpers -------------------------------------------

// UTC <Created> timestamp in ONVIF form, e.g. 2026-07-21T04:20:20.000Z. Returns
// false (but still fills buf) if SNTP hasn't synced yet -- the clock reads ~1970
// then, which a real camera rejects for skew; the caller logs a warning.
static bool onvifCreatedNow(char* buf, size_t cap) {
  time_t now = time(nullptr);
  struct tm tmv;
  gmtime_r(&now, &tmv);
  char t[24];
  strftime(t, sizeof t, "%Y-%m-%dT%H:%M:%S", &tmv);
  snprintf(buf, cap, "%s.000Z", t);
  return tmv.tm_year + 1900 >= 2020;   // synced if the year is sane
}

// Build the WS-Security header for one request into securityBuf: fresh random
// nonce, current Created, and PasswordDigest = Base64(SHA1(nonce+Created+pass)).
static void onvifBuildSecurity(int cam) {
  const char* user = settings.cameraUser[cam];
  const char* pass = settings.cameraPass[cam];

  uint8_t nonce[16];
  for ( int i = 0; i < 16; i += 4 ) {
    uint32_t r = esp_random();
    memcpy(nonce + i, &r, 4);
  }
  char nonceB64[32]; size_t nb = 0;
  mbedtls_base64_encode((unsigned char*)nonceB64, sizeof nonceB64, &nb, nonce, sizeof nonce);
  nonceB64[nb] = '\0';

  char created[32];
  if ( !onvifCreatedNow(created, sizeof created) )
    logw("ONVIF: clock not NTP-synced yet; camera %d may reject the timestamp", cam + 1);

  // SHA1( nonce || Created || password )
  uint8_t digest[20];
  {
    mbedtls_sha1_context ctx;
    mbedtls_sha1_init(&ctx);
    mbedtls_sha1_starts(&ctx);
    mbedtls_sha1_update(&ctx, nonce, sizeof nonce);
    mbedtls_sha1_update(&ctx, (const unsigned char*)created, strlen(created));
    mbedtls_sha1_update(&ctx, (const unsigned char*)pass, strlen(pass));
    mbedtls_sha1_finish(&ctx, digest);
    mbedtls_sha1_free(&ctx);
  }
  char digestB64[32]; size_t db = 0;
  mbedtls_base64_encode((unsigned char*)digestB64, sizeof digestB64, &db, digest, sizeof digest);
  digestB64[db] = '\0';

  snprintf(securityBuf, sizeof securityBuf, securityFormat, user, digestB64, nonceB64, created);
}

// Compose one full HTTP request (headers + SOAP envelope) into messageBuf for the
// given camera and pre-formatted action body. With no username configured the
// request is sent anonymously (empty WS-Security header) -- many ONVIF cameras
// permit unauthenticated access, and that mirrors how generic clients probe.
static void onvifBuildMessage(int cam, const char* body) {
  if ( settings.cameraUser[cam][0] == '\0' ) securityBuf[0] = '\0';   // anonymous
  else                                        onvifBuildSecurity(cam);
  snprintf(soapBuf, sizeof soapBuf, envelopeFormat, securityBuf, body);
  snprintf(messageBuf, sizeof messageBuf, httpFormat,
    settings.cameraIP[cam][0], settings.cameraIP[cam][1],
    settings.cameraIP[cam][2], settings.cameraIP[cam][3],
    (int)strlen(soapBuf), soapBuf);
}

/*
Velocity [PTZSpeed]
A Velocity vector specifying the velocity of pan, tilt and zoom.
PanTilt - optional; [Vector2D]
Pan and tilt speed. The x component corresponds to pan and the y component to tilt. If omitted in a request, the current (if any) PanTilt movement should not be affected.
Zoom - optional; [Vector1D]
A zoom speed. If omitted in a request, the current (if any) Zoom movement should not be affected.

<ns0:ContinuousMove xmlns:ns0="http://www.onvif.org/ver20/ptz/wsdl">
    <ns0:ProfileToken>MediaProfile00000</ns0:ProfileToken>
    <ns0:Velocity>
        <ns1:PanTilt xmlns:ns1="http://www.onvif.org/ver10/schema" x="0.041666666666666664" y="0"/>
        <ns2:Zoom xmlns:ns2="http://www.onvif.org/ver10/schema" x="0"/>
    </ns0:Velocity>
</ns0:ContinuousMove>
*/

void onvif_setup() {
    // cycle through each camera 
    // see if it is using onvif
    // if first octet is not 0
    // get ptz serivce name from device service
    // get profile token name
    // set presets 1 and 2
}

// Surface ONVIF command failures instead of silently discarding the reply. A
// camera (and the sim) answers a bad/unauthorized request with HTTP 4xx/5xx and
// a SOAP <Fault> carrying a ter:* Subcode + a human <Reason><Text>. Without this,
// a wrong/blank password just made the camera sit still with no clue why.
// Throttled to one line per camera per 2s so driving a mis-configured camera
// doesn't re-flood the log.
static void onvifCheckResponse( int cam, const char* buf ) {
    int http = 0;                                  // "HTTP/1.1 400 ..." -> 400
    const char* sp = strchr( buf, ' ' );
    if ( sp ) http = atoi( sp + 1 );
    bool fault = strstr( buf, "Fault" ) != nullptr;
    if ( !fault && ( http == 0 || ( http >= 200 && http < 300 ) ) ) return;   // success

    char reason[80] = "";
    const char* t = strstr( buf, ":Text" );        // <s:Text xml:lang="en">reason</s:Text>
    const char* gt = t ? strchr( t, '>' ) : nullptr;
    if ( gt ) { gt++; size_t i = 0; while ( gt[i] && gt[i] != '<' && i < sizeof(reason)-1 ) { reason[i] = gt[i]; i++; } reason[i] = 0; }
    if ( !reason[0] ) {                            // fall back to the ter:* subcode
        const char* c = strstr( buf, "ter:" );
        if ( c ) { size_t i = 0; while ( c[i] && c[i] != '<' && c[i] != ' ' && i < sizeof(reason)-1 ) { reason[i] = c[i]; i++; } reason[i] = 0; }
    }

    static uint32_t lastLogAt[NUM_CAMERAS + 1] = { 0 };
    if ( cam >= 0 && cam <= NUM_CAMERAS && millis() - lastLogAt[cam] < 2000 ) return;
    if ( cam >= 0 && cam <= NUM_CAMERAS ) lastLogAt[cam] = millis();
    logw( "ONVIF cam %d rejected the command: HTTP %d%s%s (check ONVIF user/password)",
          cam + 1, http, reason[0] ? " -- " : "", reason[0] ? reason : "" );
}

void onvif_send( int cameraNumber ) {
    //byte messageBuf[2048];
    if (NETWORK_SUCCESS != camConnect(cameraNumber)) {
        //VISCA_ERROR("E97");
        logi("Onvif could not connect");
    }

    if (NETWORK_SUCCESS != camSend(cameraNumber, (byte*)messageBuf, strlen(messageBuf))) {
        //VISCA_ERROR("E96");
        logi("Onvif could not send");
    }
    //logi("Message sent: %s", messageBuf);

    // camRecv() returns the byte count on success (>0), so treat any non-positive
    // result as a failure rather than comparing against NETWORK_SUCCESS.
    int rlen = camRecv(cameraNumber, (byte*)messageBuf, sizeof(messageBuf));
    if (rlen <= 0) {
        logw("ONVIF cam %d: no response", cameraNumber + 1);
    } else {
        messageBuf[rlen < (int)sizeof(messageBuf) ? rlen : (int)sizeof(messageBuf) - 1] = '\0';
        onvifCheckResponse(cameraNumber, messageBuf);
    }

    camClose(cameraNumber);
}

// ONVIF health probe: ONVIF is an HTTP/SOAP service, so a VISCA-style inquiry is
// meaningless -- TCP reachability of the service is the signal. onvif_send()
// opens a fresh socket per call, so connect, treat success as up, then close.
// (Could be upgraded to an unauthenticated GetSystemDateAndTime probe later.)
int onvifStatus(int cameraNumber) {
    int ok = camConnect(cameraNumber);
    camClose(cameraNumber);
    return (ok == NETWORK_SUCCESS) ? CAMERA_UP : CAMERA_DOWN;
}

void initialize() {
    Onvif_SetPreset(1);
    Onvif_SetPreset(2);
}

void Onvif_GoToPreset( int presetNumber ) {
    int cam = getActiveCamera();
    char body[160]; snprintf(body, sizeof body, goToPresetBody, presetNumber);
    onvifBuildMessage(cam, body);
    onvif_send(cam);
}

void Onvif_GetPresets( int cameraNumber ) {
    onvifBuildMessage(cameraNumber, getPresetsBody);
    onvif_send(cameraNumber);
}

void Onvif_SetPreset( int presetNumber ) {
    int cam = getActiveCamera();
    char body[160]; snprintf(body, sizeof body, setPresetBody, presetNumber);
    onvifBuildMessage(cam, body);
    onvif_send(cam);
}

void Onvif_ZoomDrive(int zoomSpeed) {

}

void Onvif_PanTiltDrive(int panSpeed, int tiltSpeed) {
    int cam = getActiveCamera();
    // velBody uses %1.3f -- pass normalized doubles, not ints (varargs UB).
    char body[320]; snprintf(body, sizeof body, velBody, panSpeed / 15.0, tiltSpeed / 15.0);
    onvifBuildMessage(cam, body);
    logi("Sending pan tilt message x:%d y:%d", panSpeed, tiltSpeed);
    onvif_send(cam);
}

void Onvif_Stop(bool stopPanTilt, bool stopZoom) {
    int cam = getActiveCamera();
    char body[220]; snprintf(body, sizeof body, stopBody,
                             stopZoom ? "true" : "false", stopPanTilt ? "true" : "false");
    onvifBuildMessage(cam, body);
    logi("Stopping");
    onvif_send(cam);
}

void Onvif_PtzDrive( int panSpeed, int tiltSpeed, int zoomSpeed ) {
    //logi("curr p: %d, prev p:%d, curr t: %d, prev t: %d, curr z: %d, prev z: %d", panSpeed, prevPan, tiltSpeed, prevTilt, zoomSpeed, prevZoom);
    if ((panSpeed == prevPan) && (tiltSpeed == prevTilt) && (zoomSpeed == prevZoom)) { 
        //Serial.println("Not sending any message");
        return;
    }

    int cam = getActiveCamera();

    //char camIP[] = "192.168.4.200";
    //logi("%s","Creating buffers");
    //Values must be between -1 and 1

    if ((zoomSpeed == 0) && (prevZoom != 0)) {
        char body[220]; snprintf(body, sizeof body, stopBody, "true", "false");   // stop Zoom, leave PanTilt
        onvifBuildMessage(cam, body);
        logi("Stopping zoom");
        onvif_send(cam);
    } else {
        char body[320]; snprintf(body, sizeof body, zoomBody, zoomSpeed / 7.0);
        onvifBuildMessage(cam, body);
        logi("Sending zoom message z:%d", zoomSpeed);
        onvif_send(cam);
    }
    //logi("cp:%d pp:%d ct:%d pt:%d", panSpeed, prevPan, tiltSpeed, prevTilt);
    if (((panSpeed == 0) && (tiltSpeed == 0)) && ((prevPan != 0) || (prevTilt != 0))) {
        char body[220]; snprintf(body, sizeof body, stopBody, "false", "true");   // stop PanTilt, leave Zoom
        onvifBuildMessage(cam, body);
        logi("Stopping pan tilt");
        onvif_send(cam);
    } else {
        char body[320]; snprintf(body, sizeof body, velBody, panSpeed / 15.0, tiltSpeed / 15.0);
        onvifBuildMessage(cam, body);
        logi("Sending pan tilt message x:%d y:%d", panSpeed, tiltSpeed);
        onvif_send(cam);
    }

    prevPan = panSpeed;
    prevTilt = tiltSpeed;
    prevZoom = zoomSpeed; 
    ///sprintf(headerBuf, headerFormat, 666);
    //printf("%s", headerBuf);  
    /*   
        char buffer[1024] = { 0 };
    if ((client_fd = socket(AF_INET, SOCK_STREAM, 0)) < 0) {
        printf("\n Socket creation error \n");
        //return -1;
    }
 
    serv_addr.sin_family = AF_INET;
    serv_addr.sin_port = htons(PORT);
 
    // Convert IPv4 and IPv6 addresses from text to binary
    // form
    if (inet_pton(AF_INET, "192.168.4.200", &serv_addr.sin_addr)
        <= 0) {
        printf(
            "\nInvalid address/ Address not supported \n");
        //return 0;
    }
 
    if ((status
         = connect(client_fd, (struct sockaddr*)&serv_addr,
                   sizeof(serv_addr)))
        < 0) {
        printf("\nConnection Failed \n");
        //return 0;
    }
    send(client_fd, messageBuf, strlen(messageBuf), 0);
    printf("move message sent\n");
    valread = read(client_fd, buffer,
                   1024 - 1); // subtract 1 for the null
                              // terminator at the end
    printf("%s\n", buffer);
    // closing the connected socket
    close(client_fd);
    */
}

// ---------------------------------------------------------------------------
// ONVIF WS-Discovery client. Multicasts a Probe to 239.255.255.250:3702 and
// collects ProbeMatch replies. Each reply's <XAddrs> URL carries the camera's
// ip:port, so several ONVIF cameras can share one IP on different ports.
// Appends to discoveredCameras[]. Blocks the loop ~2s (manual "Discover" only).
// ---------------------------------------------------------------------------
static const char wsDiscoveryProbe[] =
"<?xml version=\"1.0\" encoding=\"UTF-8\"?>"
"<e:Envelope xmlns:e=\"http://www.w3.org/2003/05/soap-envelope\" "
"xmlns:w=\"http://schemas.xmlsoap.org/ws/2004/08/addressing\" "
"xmlns:d=\"http://schemas.xmlsoap.org/ws/2005/04/discovery\" "
"xmlns:dn=\"http://www.onvif.org/ver10/network/wsdl\">"
"<e:Header>"
"<w:MessageID>urn:uuid:churchcam-%08x</w:MessageID>"
"<w:To e:mustUnderstand=\"true\">urn:schemas-xmlsoap-org:ws:2005:04:discovery</w:To>"
"<w:Action mustUnderstand=\"true\">http://schemas.xmlsoap.org/ws/2005/04/discovery/Probe</w:Action>"
"</e:Header>"
"<e:Body><d:Probe><d:Types>dn:NetworkVideoTransmitter</d:Types></d:Probe></e:Body>"
"</e:Envelope>";

// Pull ip+port from the first http:// URL in a ProbeMatch (<XAddrs>). Port
// always comes from the URL; IP comes from the URL when it is a literal,
// otherwise the caller's source IP is kept.
static void parseXAddr(const char *body, IPAddress &ip, uint16_t &port) {
  // Search only from the <XAddrs> element onward. The SOAP envelope is full of
  // earlier http:// URLs (WS-Addressing Action, xmlns namespaces); grabbing the
  // first one in the whole body parsed a schema host with no port -> every
  // camera defaulted to :80 and collapsed to one entry under the ip+port dedup.
  const char *x = strstr(body, "XAddrs");
  const char *h = strstr(x ? x : body, "http://");
  if (!h) return;
  h += 7;
  char host[64];
  int i = 0;
  while (*h && *h != ':' && *h != '/' && *h != '<' && *h != ' ' && i < 63) host[i++] = *h++;
  host[i] = 0;
  if (*h == ':') port = atoi(h + 1);
  IPAddress parsed;
  if (parsed.fromString(host)) ip = parsed;
}

// Optional friendly name from a Scopes ".../name/<x>" token.
static void parseScopeName(const char *body, char *out, size_t cap) {
  strlcpy(out, "ONVIF Camera", cap);
  const char *n = strstr(body, "/name/");
  if (!n) return;
  n += 6;
  size_t i = 0;
  while (n[i] && n[i] != ' ' && n[i] != '<' && n[i] != '/' && i < cap - 1) { out[i] = n[i]; i++; }
  if (i) out[i] = 0;
}

int discoverOnvifCameras() {
  int fd = lwip_socket(AF_INET, SOCK_DGRAM, IPPROTO_UDP);
  if (fd < 0) { loge("ONVIF discovery: socket() failed\n"); return 0; }

  // Bind an ephemeral local port so unicast replies come back to us.
  struct sockaddr_in local;
  memset(&local, 0, sizeof local);
  local.sin_family = AF_INET;
  local.sin_addr.s_addr = htonl(INADDR_ANY);
  local.sin_port = 0;
  lwip_bind(fd, (struct sockaddr *)&local, sizeof local);

  // Route multicast out the active interface (ETH on the PoE board) and join
  // the group so we also catch any multicast ProbeMatch replies.
  IPAddress lip = localIP();
  IPAddress mcast(239, 255, 255, 250);
  struct in_addr mif;
  mif.s_addr = (uint32_t)lip;
  lwip_setsockopt(fd, IPPROTO_IP, IP_MULTICAST_IF, &mif, sizeof mif);
  uint8_t ttl = 2;
  lwip_setsockopt(fd, IPPROTO_IP, IP_MULTICAST_TTL, &ttl, sizeof ttl);
  struct ip_mreq mreq;
  mreq.imr_multiaddr.s_addr = (uint32_t)mcast;
  mreq.imr_interface.s_addr = (uint32_t)lip;
  lwip_setsockopt(fd, IPPROTO_IP, IP_ADD_MEMBERSHIP, &mreq, sizeof mreq);

  struct timeval tv;
  tv.tv_sec = 0;
  tv.tv_usec = 300000;   // 300ms per recv; total window bounded below
  lwip_setsockopt(fd, SOL_SOCKET, SO_RCVTIMEO, &tv, sizeof tv);

  struct sockaddr_in dst;
  memset(&dst, 0, sizeof dst);
  dst.sin_family = AF_INET;
  dst.sin_port = htons(3702);
  dst.sin_addr.s_addr = (uint32_t)mcast;

  char probe[900];
  snprintf(probe, sizeof probe, wsDiscoveryProbe, (unsigned)millis());
  logi("ONVIF WS-Discovery: probing %s:3702 via %s", mcast.toString().c_str(), lip.toString().c_str());
  lwip_sendto(fd, probe, strlen(probe), 0, (struct sockaddr *)&dst, sizeof dst);

  int found = 0;
  char buf[1500];
  uint32_t start = millis();
  while (millis() - start < 2000) {
    struct sockaddr_in from;
    socklen_t fl = sizeof from;
    memset(&from, 0, sizeof from);
    int len = lwip_recvfrom(fd, buf, sizeof(buf) - 1, 0, (struct sockaddr *)&from, &fl);
    if (len <= 0) {
      if (errno == EAGAIN || errno == EWOULDBLOCK) continue;   // recv timeout, keep waiting
      break;
    }
    buf[len] = 0;
    if (!strstr(buf, "ProbeMatch")) continue;

    IPAddress ip = IPAddress(from.sin_addr.s_addr);
    uint16_t port = 80;
    parseXAddr(buf, ip, port);
    char name[24];
    parseScopeName(buf, name, sizeof name);
    if (addDiscovered(ip, port, CAM_ONVIF, CAM_TCP, 1, name)) {   // ONVIF ignores VISCA framing
      logi("ONVIF camera: %s:%u \"%s\"", ip.toString().c_str(), port, name);
      found++;
    }
  }
  lwip_close(fd);
  logi("ONVIF discovery found %d camera(s)", found);
  return found;
}

/* GotoPreset??
[GotoPreset]
ProfileToken [ReferenceToken]
A reference to the MediaProfile where the operation should take place.
PresetToken [ReferenceToken]
A requested preset token.
Speed - optional; [PTZSpeed]
A requested speed.The speed parameter can only be specified when Speed Spaces are available for the PTZ Node.
PanTilt - optional; [Vector2D]
Pan and tilt speed. The x component corresponds to pan and the y component to tilt. If omitted in a request, the current (if any) PanTilt movement should not be affected.
Zoom - optional; [Vector1D]
A zoom speed. If omitted in a request, the current (if any) Zoom movement should not be affected.
*/
