paulkilroy/ChurchCam/(commit log)

2023-03-03 Update to stable changes feb 2023
    [CamCase1.scad]
2023-03-03 Updates to SCAD for better fit
    [CamCase1.scad]
2023-03-20 Random fixes - compression of css/js, restart file
    [CameraControl.cpp, ChurchCam.cpp, Display.cpp, Web.cpp, globals.h]
2024-02-10 A few minor fixes for the latest esp libraries.
    [ChurchCam.cpp, Display.cpp]
2024-02-17 reduced memory footprint
2024-02-24 Updated Case for bigger color screen
    [CamCase1.scad]
2025-03-27 Even bigger screen
    [CamCase1.scad]
2025-04-04 bigger screen cad
    [CamCase1.scad]
2026-07-09 Pin mWebSockets to pre-A0 commit to fix build
    The mWebSockets git dependency was unpinned, so a fresh dependency
    resolve pulled v1.6.0, which seeds its RNG with analogRead(A0). The
    Olimex ESP32-PoE board variant does not define the A0 pin macro, so
    the build failed with "'A0' was not declared in this scope".
    Pin to a4458add6 (2024-01-01) — the version current during the last
    successful build, which uses analogRead(0) and compiles on this board.
2026-07-19 Network reliability rework, discovery, protocol/transport split, Arduino-3 bump, + simulator rig
    Overhaul the camera/network layer for reliability and modern tooling, and add
    a full virtual test bench to exercise it without hardware.
    Framework bump (Arduino core 3.x / ESP-IDF 5.x via the pioarduino fork):
    - platformio.ini: switch to the pioarduino platform, bump GFX to 1.6.6.
    - Adapt to IDF5 API changes: GFX RGB565_* color shim (Display.cpp),
    MDNS.address, 6-arg ETH.begin, and NetworkInterface-based status/accessors
    (Network.cpp); esp_read_mac for reliable in-simulator detection (ChurchCam).
    CameraLink socket rewrite (NetworkUtils.cpp):
    - One raw lwIP BSD socket per camera, protocol fi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
    [CameraControl.cpp, ChurchCam.cpp, Display.cpp, Network.cpp, Onvif.cpp, Visca.cpp, Web.cpp, globals.h]
2026-07-19 Fix camera status probes and UDP socket recovery found in sim testing
    Follow-up fixes surfaced by exercising the type/transport split against the
    Wokwi/Node camera sim.
    Per-protocol status probes (was: VISCA power inquiry fired at every camera):
    - Move cameraStatus() to the protocol-agnostic dispatch layer (CameraControl):
    shared reachability/NA checks, then dispatch to viscaStatus() (VISCA power
    inquiry, Visca.cpp) or onvifStatus() (TCP reachability, Onvif.cpp). Visca.cpp
    and Onvif.cpp no longer know about each other. Fixes ONVIF cameras showing as
    errored (they were being sent VISCA bytes) and stops polluting their HTTP
    parsers.
    UDP socket self-heal (NetworkUtils):
    - camConnect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
    [CameraControl.cpp, Onvif.cpp, Visca.cpp, globals.h]
2026-07-19 Migrate web stack to PsychicHttp; embed assets in flash; cache camera status
    Replace the synchronous Arduino WebServer + mWebSockets with one async
    PsychicHttp server, retire the convert.py/WebFiles.cpp asset pipeline in favor
    of flash-embedded files, and cache camera status so the async handlers never
    race the main loop on a camera socket.
    Server (Web.cpp):
    - One PsychicHttp server on port 80 serves the config UI AND the joystick/PTZ
    telemetry WebSocket at /ws -- the separate mWebSockets server on port 3000 is
    gone (removed from globals, CameraControl, Network, lib_deps; config.html now
    connects to ws://<host>/ws).
    - The config page streams through PsychicHttp's TemplatePrinter with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
    [CameraControl.cpp, Network.cpp, Web.cpp, globals.h]
2026-07-19 Make the log ring cross-task safe and fix a latent out-of-bounds
    The four log functions (display_i/logd/logw/loge) each bumped a shared uint8_t
    ptr/count and wrote LogItems[ptr] with no synchronization, so concurrent callers
    (main loop, WiFi/ETH event task, and now the async PsychicHttp task) could
    corrupt the ring pointers or overwrite each other's slot. ptr/count were also
    never reduced modulo LOG_SIZE, so once ptr passed LOG_SIZE-1 both writes and
    reads indexed past the array.
    - Factor the four functions into one logAppend() helper. Formatting happens on
    the caller's stack (vsnprintf into a local); only the ptr bump + slot claim run
    under a brief portMUX critical section, and ptr is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
2026-07-20 Operator console screen overhaul + operator/setup manual
    Rewrite the 320x240 display into a proper operator console plus a set of
    full-screen states, driven by a small state machine in displayLoop().
    Console:
    - Header: Wi-Fi signal bars / Ethernet glyph, hostname/IP/RSSI, an ATEM pill,
    and a big ON AIR / OFF AIR streaming indicator (getStreamStreaming).
    - Tally box: the driven camera, framed red on Program / green on Preview / grey
    off, with a big logisoso62 number and a caps status line.
    - Radar: live pan/tilt dot + zoom rail (both red on a Program camera).
    - Camera bus: all 8 inputs with PRG/PVW tally, connected, configured-but-no-reply
    (amber !), and unconfigured (dim) states, plus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
2026-07-20 Audit fixes: ONVIF stop bug, VISCA dup-suppression, camRecv length, OTA/status/display hardening
    Correctness / safety:
    - Onvif: pan/tilt STOP now fills soapBuf before sending (was sending the raw
    %s template, so the camera never stopped). Fix Zoom xmlns spacing and the
    int-passed-as-%1.3f UB in Onvif_PanTiltDrive.
    - Visca: gate dup-suppression on !waitForAck && !waitForComplete, so a repeated
    power inquiry no longer returns a zeroed response and falsely reports DOWN.
    - NetworkUtils: camRecv() returns the byte count on success (needed by VISCA
    discovery name parsing); update Onvif caller to test <= 0 instead of
    == NETWORK_SUCCESS.
    - Network: static-IP branches were swapped (WiFi.con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
    [CameraControl.cpp, Display.cpp, Network.cpp, Onvif.cpp, Visca.cpp, Web.cpp, globals.h]
2026-07-20 Web UI: remove jQuery/CDN dependency, fix duplicate id attributes
    The config page loaded jQuery from a Google CDN, so on an offline/isolated
    church LAN the two jQuery-dependent features -- camera discovery and the OTA
    firmware-upload progress bar -- silently broke. Rewrite both with the
    Bootstrap 5 modal API and a native XMLHttpRequest upload (fetch has no
    upload-progress event), and drop the CDN <script> tag entirely.
    Also remove the duplicate id="basic-addon1" attributes (invalid HTML; the
    browser silently dropped the second id) on the ATEM and camera config rows.
2026-07-20 Cap NUM_CAMERAS at 8 (design ceiling), bump SETTINGS_VERSION
    The largest ATEM in this class has 8 inputs and the on-device camera strip is
    laid out for exactly 8 tiles, so 20 was never reachable. Lowering the constant
    also shrinks the Settings struct, so bump SETTINGS_VERSION to 2 to discard the
    old-layout EEPROM blob on first boot. Tie the display strip's tile count to
    NUM_CAMERAS so the two can't drift apart.
    [Display.cpp, globals.h]
2026-07-20 Reorg: rename modules, bundle joystick input into a struct, clarify dedup note
    - Rename CameraControl.cpp -> Controller.cpp (joystick/buttons/control loop) and
    NetworkUtils.cpp -> CameraLink.cpp (it implements the CameraLink socket layer).
    Replace the stale "New Design" TODO in ChurchCam.cpp with an accurate module map.
    - Introduce struct JoystickState and pass it by const-ref to displayLoop instead
    of six loose ints. Confined to the main-loop task (not a global), so it can't be
    torn by the async web task -- the safer answer to "stop passing them everywhere".
    - Downgrade the pan/tilt-vs-zoom dedup TODO to a comment explaining why per-type
    suppression is intentionally omitted (ptzDr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
    [CameraLink.cpp, ChurchCam.cpp, Controller.cpp, Display.cpp, Web.cpp, globals.h]
2026-07-20 Capture per-camera ONVIF credentials in settings + config UI
    Add settings.cameraUser[]/cameraPass[] (bump SETTINGS_VERSION to 3) and the
    matching ONVIF username/password fields on the config page, shown only when a
    camera's type is ONVIF (VISCA has no auth). The username round-trips through the
    page; the password is never echoed back -- an empty field on save means "keep
    the existing password", so it isn't wiped by a normal save.
    This is the data-capture half of ONVIF auth. Generating the actual WS-Security
    digest (SHA1+base64 + random nonce + NTP-based Created timestamp) is deferred to
    hardware bring-up, where it can be validated against a real camera; a wrong
    digest is otherwise indisting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
    [Onvif.cpp, Web.cpp, globals.h]
2026-07-20 ONVIF WS-Security auth: real digest + NTP, sim validates like a real camera
    Firmware:
    - Compute a proper WS-UsernameToken per request: PasswordDigest =
    base64(SHA1(random 16-byte nonce + Created + password)), via mbedtls sha1/
    base64 and esp_random. Credentials come from settings.cameraUser/cameraPass.
    - Refactor the six baked SOAP envelopes (each with a duplicated hardcoded
    Security header) into a shared envelopeFormat + securityFormat + per-action
    body fragments; onvifBuildMessage() assembles and signs each request.
    - Add SNTP (configTime pool.ntp.org/time.nist.gov) in networkSetup for the UTC
    <Created>; onvifCreatedNow() warns if the clock isn't synced yet.
    - Onvif_Stop now hono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
2026-07-20 Dedup VISCA drive resends per (camera, message-type) via a shared helper
    Replace the single global visca_previous buffer -- which never matched during
    simultaneous pan/tilt + zoom because the two packets alternate through it -- with
    a shared, camera-keyed, message-type-keyed cache in CameraLink:
    camIsRepeat()/camNoteSent()/camResetDedup().
    visca_send() gains an optional msgType arg (default CAM_MSG_NONE). Only drive
    commands opt in (CAM_MSG_PANTILT / CAM_MSG_ZOOM from ptzDrive); inquiries and
    one-shots stay CAM_MSG_NONE so they always go out -- preserving the fix that a
    power inquiry is never suppressed into a false CAMERA_DOWN. History is recorded
    only after a successful send, and cleared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
    [CameraLink.cpp, Visca.cpp, globals.h]
2026-07-20 ONVIF: support anonymous (no-credential) cameras; sim demos both paths
    Many ONVIF cameras -- especially cheap CCTV -- permit anonymous access and need
    no username/password. Mirror how generic clients behave: when a camera has no
    username configured, send the request with an empty WS-Security header instead
    of a signed UsernameToken.
    Simulator now models both real-world cases: Camera 3 requires auth (admin/
    churchcam), Camera 4 runs anonymously and accepts any request. The firmware's
    configureSimulatorTargets preloads Camera 3's credentials and leaves Camera 4
    blank, so both ONVIF auth paths are exercised out of the box.
    Builds green; sim syntax-checked.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
2026-07-30 Add a fading light trail to the joystick radar dot
    Short (8-sample) fading tail of recent dot positions on the radar, drawn from a
    ring buffer since the display full-redraws every frame. Uses a fade565() helper
    to dim the tally color toward black over ~6 discrete shades (palette-cheap on the
    indexed canvas), with a slight size taper and the solid dot on top. Tally-colored
    (green preview / red on-air) so it reads as light feedback, not pure decoration.
    Seeded to the current point so there's no stray tail on boot; retracts into the
    dot when the stick stops. Traces joystick deflection, not camera aim (same caveat
    as the dot itself).
    Tunables: TRAIL_N (length), the 40 fade floor, the 1 + i/3 th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
    [Display.cpp]
2026-09-07 Hardware bring-up: native-HSPI display, button pin remap, fix save-reboot
    - Display.cpp: move the ILI9341 SPI onto the ESP32's native HSPI pins
    (SCK 14 / MOSI 13 / CS 15, DC 5, RST 4, BL 2) via Arduino_ESP32SPI on the HSPI
    bus, so it runs the IOMUX fast path with DMA. Validated on real hardware.
    - ChurchCam.cpp: remap the recall buttons off the display pins they collided with
    -- recall1 14->16, recall2 5->34 (34 is input-only but the board already has a
    10k pull-up on it).
    - Web.cpp: consume the Restart flag in webLoop(). /save set Restart=true but
    NOTHING read it, so saving Wi-Fi settings persisted to EEPROM but never rebooted
    -- the device kept running in its boot-time (AP) mod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
    [ChurchCam.cpp, Display.cpp, Web.cpp]
2026-09-07 Start the config AP from loop context so WiFi-fail recovery actually works
    When STA association fails with no Ethernet, the WiFi event handler called
    WiFi.softAP() directly -- but softAP() from inside the event task logs "Starting
    AP" without reliably broadcasting, so the device was left with no WiFi, no
    Ethernet, and no reachable AP (truly stuck; the "ptz-setup" SSID never appeared).
    The event handler now just flags the request; networkServicesLoop() starts the AP
    in loop context, the same place the initial config AP is started.
    Also: recall2 moved to GPIO34 (input-only, no internal pull-up -- the Olimex
    board has a 10k on it), so pinMode is INPUT not INPUT_PULLUP; kills the
    "input-only pa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
    [Controller.cpp, Network.cpp]
2026-09-07 Add WiFi network scan to the config page
    A "Scan for networks" button on the Network Config tab hits a new /scanWifi
    endpoint (WiFi.scanNetworks -> JSON [{ssid, rssi, secure}]) and lists nearby APs
    sorted by signal strength, with a strong/good/fair/weak badge and a lock icon for
    secured networks. Clicking a row fills the SSID field.
    Because the ESP32 radio is 2.4 GHz only, 5 GHz networks never appear -- so the
    operator can't pick one it can't join (which is exactly what "Mahal" -> 201
    NO_AP_FOUND was), and there's no SSID to mistype.
    Builds green.
2026-09-07 Restart page: guide the user after a Wi-Fi change instead of spinning forever
    Saving a new Wi-Fi network moves the controller off the ptz-setup hotspot onto
    that network, so the restart page (polling /ping on 192.168.4.1) could never
    reach it again and hung on "...updated settings" forever.
    The page still polls /ping and redirects when the device is reachable on the SAME
    network (e.g. only camera/ATEM settings changed). But after ~9s with no response
    it now reveals a panel explaining the device joined your Wi-Fi and how to find it:
    reconnect to your Wi-Fi and open http://ptz-setup.local, or the IP shown on the
    controller's screen. Also tidied the page layout.
    Builds green.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
2026-09-07 Joystick center recalibration (config page) + deadzone box tracks it
    - Control loop now centers the deadzone/speed mapping on settings.panMid/tiltMid/
    zoomMid (default AnalogMax/2, so no behavior change until calibrated) instead of
    a hardcoded midpoint -- an off-center stick no longer reads as a constant drive.
    - New "Recalibrate Center" button on the config joystick tab hits /calibrateCenter:
    the control loop (which owns the ADC) averages the resting position, stores it as
    the new center, and persists to EEPROM. Center the stick, click, done.
    - The config page's per-axis deadzone boxes now position at the calibrated center
    (PAN_MID/TILT_MID/ZOOM_MID template vars + a --center CSS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
    [Controller.cpp, Web.cpp, globals.h]
2026-09-07 Widen WiFi credential buffers to spec (ssid 33, psk 64)
    settings.psk was char[32], capping the WPA passphrase at 31 chars -- a longer
    password was silently truncated, which authenticates with the wrong key and shows
    as Reason 2 AUTH_EXPIRE. WPA allows 63 chars; SSID allows 32. Bump to ssid[33] /
    psk[64] and SETTINGS_VERSION 4 (EEPROM re-inits). PsychicHttp already URL-decodes
    POST params, so special characters like '@' were never the problem.
    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
    [globals.h]
2026-09-07 Retry WiFi association a few times before falling back to the config AP
    The ESP32 commonly throws a transient AUTH_EXPIRE on the first association attempt
    even with the correct password, and the handler was giving up after ONE failure --
    switching to the config AP and killing the connection. Now a STA disconnect (when
    WiFi has never connected and there's no Ethernet) retries via a fresh WiFi.begin()
    in loop context, up to MAX_WIFI_ATTEMPTS (5), before requesting the AP. The attempt
    counter resets on GOT_IP.
    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
    [Network.cpp]
2026-09-07 WiFi retry: rely on auto-reconnect, drop the redundant explicit begin
    The retry counter worked (associated on attempt 2 on hardware), but the extra
    loop-context WiFi.begin() raced the radio's own auto-reconnect and logged
    "sta is connecting, cannot set config / STA clear config failed". Auto-reconnect
    is what actually reconnects, so just count the failed attempts and hold the AP
    fallback until MAX -- no explicit begin, no error spam.
    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
    [Network.cpp]
2026-09-07 Center the config deadzone box vertically on the joystick slider
    The box used a margin-top:-1em hack that left it sitting above the pan/tilt/zoom
    slider tracks. Center it with top:50% + translateY(-50%) so it frames the track.
2026-09-07 Pin hostname to ptz-setup so mDNS/DHCP/display all match
    getHostname() returned the interface's own name, which reports the MAC-derived
    default (esp32-XXXX) even after WiFi.setHostname("ptz-setup") -- so mDNS came up as
    esp32-XXXX.local while the AP was ptz-setup, and the restart page's ptz-setup.local
    link didn't resolve. Return AP_SSID instead, so the mDNS name, the DHCP hostname,
    and the display header are all "ptz-setup" (ptz-setup.local).
    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
    [Network.cpp]
2026-09-07 Sim: advertise the virtual ATEM over mDNS for firmware auto-discovery
    The firmware discovers the ATEM via MDNS.queryService("blackmagic","tcp") at
    network bring-up, but the sim advertised nothing (queryService found nothing).
    Add a minimal hand-rolled mDNS responder (zero-dep, over dgram): on a query for
    _blackmagic._tcp it answers PTR + SRV + TXT + A pointing at the host's LAN IP :9910,
    so the controller sets switcherIP and connects. Ignores responses (incl. its own)
    to avoid a loop; binds :5353 with reuseAddr (shares macOS's mDNSResponder) and
    degrades gracefully if the bind fails.
    Cameras already had discovery (VISCA reply + ONVIF WS-Discovery). Service name
    _blackmagic._tcp matches the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
2026-09-07 Config: 1-index the fallback camera name to match ATEM CAM1.. and the display
    An un-named camera fell back to "Camera 0..7" (0-based) while the ATEM inputs are
    "CAM1..4" and the device display counts from 1 -- so the list jumped from 0-based
    to 1-based the moment the ATEM connected. Use String(i+1) so it's 1-based
    everywhere.
    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
2026-09-07 Discovery modal: show type + port; make sim camera names consistent
    The discover modal listed only name + IP, so you couldn't see whether a found
    camera was VISCA/ONVIF or on which port. Add a "VISCA UDP"/"ONVIF TCP" column and
    show ip:port. Also fix the duplicate discovedCam0Name/IP element ids (were
    hardcoded to 0 for every row).
    Sim: VISCA discovery sent "Camera 1" (with a space) while ONVIF's WS-Discovery
    scope sent "Camera3" (no space -- a space would terminate the scope name in
    parseScopeName). Drop the VISCA space so both report "Camera1"/"Camera3".
    Builds green; sim syntax-checked.
2026-09-08 ONVIF discovery: parse port from XAddrs, not the first http:// in the reply
    parseXAddr() grabbed the first "http://" in the whole SOAP envelope, which is
    a WS-Addressing namespace URL (e.g. http://www.w3.org/2003/05/soap-envelope) --
    a schema host with no port. Every ONVIF camera therefore resolved to <ip>:80
    and, since discoveredCameras dedups on (ip, port), a second camera on the same
    IP collapsed onto the first and vanished. On the sim this dropped Camera 4
    (:8084) and mis-reported Camera 3 as :80.
    Anchor the search on the <XAddrs> element first, then take the http:// inside
    it -- so the real device-service port is parsed. Verified on hardware: both
    ONVIF cameras now appear on 8083 and 8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
    [Onvif.cpp]
2026-09-08 ETH: hold PHY power and init once (drop the retry that leaked the EMAC IRQ)
    Two changes to networkSetup() ETH bring-up on the Olimex ESP32-PoE:
    - Don't retry ETH.begin(). A failed esp_eth_driver_install() leaks the EMAC
    interrupt, so a second attempt dies with "No free interrupt inputs" -- retry
    can never succeed. One clean attempt only.
    - Hold the PHY's 3.3V rail on ourselves (GPIO12 high) and pass power = -1 so the
    core never treats GPIO12 as a reset pin. On this board GPIO12 gates PHY power
    through a transistor+FET, so the core's reset pulse briefly cuts power and the
    following esp_eth_phy_802_3_pwrctl() times out.
    NOTE: this removes the interrupt-leak and rules out the power-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
    [Network.cpp]
2026-09-08 Quiet the idle serial flood: drop per-packet hex dump, slow status poll
    The status poller runs every tick while the joystick is idle, sending a VISCA
    PWR_INQ plus two ONVIF probes, forever. With NETWORK_DEBUG on, every send/recv
    dumped its bytes -- a continuous flood that buried the boot log.
    - Disable NETWORK_DEBUG by default (comment to re-enable for on-wire tracing).
    - STATUS_POLL_INTERVAL_MS 300 -> 1000: full 8-slot sweep ~8s instead of ~2.4s.
2026-09-08 ONVIF: log rejected commands instead of dropping the reply silently
    onvif_send() read the HTTP response into messageBuf and ignored it, so a wrong
    or blank ONVIF password made the camera sit still with no clue why (status still
    showed green -- onvifStatus only checks TCP reachability, not auth).
    Parse the reply: on HTTP 4xx/5xx or a SOAP <Fault>, log a warning with the HTTP
    code and the fault Reason/ter:* subcode, e.g.
    ONVIF cam 3 rejected the command: HTTP 400 -- Sender not authorized (check ONVIF user/password)
    Throttled to one line per camera per 2s so driving a mis-configured camera
    doesn't re-flood the log. Also NUL-terminate the buffer before string parsing
    and warn (not info) on an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
    [Onvif.cpp]
2026-09-08 sim: add an AIR (live stream) toggle to the virtual ATEM
    The controller's ON AIR / OFF AIR badge is driven by getStreamStreaming() (the
    ATEM StRS streaming-status command), not by Program/Preview -- so there was no
    way to exercise it from the sim.
    Add a streaming state to the virtual ATEM that emits a real StRS command
    (16-bit flags, bit 2 = streaming, matching ATEMmin) on change and in the init
    dump, a POST /atem/streaming endpoint, and an AIR toggle button on the control
    page that pulses red when live. Flip it and the device shows ON AIR / OFF AIR.
2026-09-08 display: fix inverted radar tilt + fade absent-camera tiles
    - Radar dot: pushing the stick up moved the dot DOWN. The dot Y used cy - tn,
    but the tilt ADC reads low on up-deflection (same convention the control loop
    inverts for tiltSpeed), so up mapped to down. Use cy + tn -> up is up, and the
    dot now agrees with the camera's tilt direction.
    - INPUTS strip: an absent camera slot drew in COL_DIM, still fairly prominent.
    Add COL_FAINT (just above the black background) for empty slots so they nearly
    vanish and present cameras stand out.
    [Display.cpp]
2026-09-08 Setup screen: fix IP/label overlap + captive-portal auto-open
    - drawConfigScreen: the SSID and IP were drawn to the right of their labels and
    ran into them ("2. Open a browser to" collided with the IP). Stack each value
    on its own line below the label, indented.
    - Captive portal so joining the hotspot pops the config page open by itself:
    - Network.cpp starts a DNSServer when the config AP comes up, answering every
    hostname with the AP IP (DNSServer is UDP-only -> links fine with PsychicHttp,
    unlike WebServer). Pumped from networkServicesLoop().
    - Web.cpp handleNotFound redirects every unknown URL (incl. the OS connectivity
    probes) to http://<AP-IP>/ while the hotspot is u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
    [Display.cpp, Network.cpp, Web.cpp]
2026-09-08 config UI: consistent semantic button colors + brighter status green
    - Working/connected status used Bootstrap's dark alert-success text (#0f5132).
    Override to the vivid success green (#198754) so it matches the Scan buttons.
    - Buttons recolored by intent: Scan Networks + Scan Cameras + Recalibrate Center
    = green (btn-success), Restart Joystick = yellow (btn-warning), Reset All Data
    = red (btn-danger). Save stays blue so the primary commit reads distinctly.
    - Renamed "Scan for networks" -> "Scan Networks" and "Discover Cameras" ->
    "Scan Cameras".
    - Wi-Fi scan results now open in a modal styled like the Scan Cameras modal
    (header/body/footer, green Rescan) instead of an inline list,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
2026-09-08 display: 80MHz SPI + skip the blit on unchanged frames (less flicker)
    Two anti-flicker levers, both real-hardware wins:
    - gfx->begin(80000000): the full-frame blit drops from ~31ms (40MHz default) to
    ~15ms, halving the window where the panel is scanned out mid-write. Drop to
    60MHz if the ribbon shows corruption.
    - flushIfChanged(): the canvas is composed offscreen every tick anyway; only the
    blit is expensive, so FNV-hash the 76.8KB indexed framebuffer (as 32-bit words,
    ~0.4ms) and skip gfx->flush() when the frame is byte-identical to the last one.
    Idle console and the static stretches of the setup/connecting screens then stop
    touching the panel entirely.
    (No TE pin on this ILI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
    [Display.cpp]
2026-09-08 display: 80MHz corrupted the panel over the ribbon -> use 60MHz
    80MHz produced jiggly/shifting rows (SPI signal integrity over the display
    ribbon). 60MHz (~20ms blit) is the safe step up from the 40MHz default; drop to
    40000000 if 60 still shows artifacts.
2026-09-08 display: repaint dead zone on radar/zoom so pot jitter stops reflushing
    Cheap pots wander a few ADC counts at rest, nudging the radar dot and zoom bar
    every frame -> the framebuffer was never byte-identical, so flushIfChanged()
    almost never skipped and the panel got the full blit at 30fps (reads as
    constant micro-flicker). Apply ~48-count (~1px) hysteresis to the shown pan/
    tilt/zoom values: a still stick now yields an identical frame and the blit is
    skipped, so idle settles to ~1 reflush/sec (the TX histogram tick) instead of 30.
    [Display.cpp]
2026-09-08 display: partial-blit self-updating bands + stabilize RSSI (kill idle flicker)
    Follow-up to the skip-flush work. Two things still forced a full-frame blit at
    idle -- each full flush is the visible flicker:
    - RSSI drove both the header dB text and the signal bars straight from
    WiFi.RSSI(), which swings several dB read-to-read. A raw +/-5dB dead zone sat
    at the noise floor and flip-flopped. Fix: one stableRSSI() -> EMA low-pass then
    a +/-5dB dead zone, feeding both. It holds steady and only moves on a real shift.
    - The header (RSSI/IP + status pills) and the TX histogram (scrolls off the
    background poll) update on their own at idle. flushIfChanged() now hashes rows
    into three zones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
    [Display.cpp]
2026-09-08 display: dirty-tile blitting -> no full-frame repaint, ever
    Replaces the three-zone (header/body/histogram) partial-blit with a uniform
    dirty-tile grid. The canvas is composed offscreen every tick; flushIfChanged()
    hashes the frame as an 8x6 grid of 40x40 tiles and pushes only the tiles whose
    pixels changed, via the raw panel's drawIndexedBitmap (sub-region + x_skip
    stride). A joystick move repaints just the radar/zoom tiles, the histogram just
    its tiles, an unchanged frame nothing -- no full-frame blit, so no flicker
    anywhere (verified on hardware, idle and while driving).
    Chosen over layout-aware regions on purpose: the grid hashes real pixels, so it
    stays correct no matter how the UI is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
    [Display.cpp]
2026-09-09 Ethernet: dual-module clock, ETH-preferred coexistence, robust failover
    Bring-up on the ESP32-PoE-ISO surfaced that Ethernet only worked on WROOM
    modules. Fix the whole ETH path so one firmware runs on WROOM and WROVER and
    fails over to Wi-Fi cleanly.
    - RMII clock pin is module-dependent: WROOM (no PSRAM) drives it on GPIO17,
    WROVER (PSRAM owns GPIO16/17) on GPIO0. We can't enable PSRAM to detect the
    module (that reserves 16/17 and breaks WROOM's GPIO17 clock), so try one
    clock and fall back to the other, then PERSIST the winner in NVS and try it
    first next boot. Default is GPIO0 (shipping board is the WROVER). Verified on
    real WROOM and WROVER hardware.
    - Hold GPIO12 (PHY power /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
    [CameraLink.cpp, Network.cpp, globals.h]
2026-09-09 Recall buttons: analog ladder on GPIO34, freeing GPIO16 for WROVER
    GPIO16 is unusable on WROVER modules (PSRAM owns GPIO16/17), so recall1 can no
    longer live there if one firmware must run on both modules. Move recall1 +
    recall2 onto a single input-only ADC pin (GPIO34) as a resistor ladder, reusing
    the board's onboard 10k pull-up (R48): recall1 via 10k, recall2 via 3.3k, and
    the onboard BUT1 still reads as recall2. Thresholds: none>3000, recall1 in
    1400..3000, recall2 <=1400. Override stays on its own pin (GPIO32). The Wokwi
    sim keeps its discrete digital buttons. A raw-ADC log aids threshold calibration
    on real resistors.
2026-09-10 Fix mDNS-triggered boot loop: pre-create stdio lock in setup
    On a busy LAN (a church network saturated with mDNS/Bonjour multicast) the WiFi
    unit crash-looped with abort() at lock_init_generic, reached via the tcpip thread:
    mdns receive -> printf -> uart_write -> lazy stdio-lock create -> abort.
    The ESP-IDF mDNS component logs an error via raw printf() from the lwIP/tcpip
    thread when it can't allocate a packet buffer under multicast load. If that printf
    is the first use of newlib stdio, the UART VFS lock is created lazily right there
    -- in a context where the mutex allocation aborts. Our logi() uses a lower-level
    UART path and never creates that lock, so mDNS was always the first, on the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
    [ChurchCam.cpp]
2026-09-10 ATEM camera names: map controller slot N to ATEM input N (fix off-by-one)
    The config/status camera-name loop passed the 0-based slot to getInputShortName(),
    but that API is indexed by ATEM video-source (1 = Input 1). getActiveCamera()
    already uses slot = videoSource - 1, so slot i must look up video-source i+1.
    Result was the ATEM's "CAM1" landing on camera 2, camera 1 falling back to
    "Camera 1", etc. Use videoSource = i+1 for every ATEM lookup in the loop (name,
    port type, initialized), so camera N shows the ATEM's name for Input N.
    Sim: emulate an 8-input ATEM (CAM1..CAM8) instead of 4, so the full 8-camera name
    mapping can be exercised on the bench (a real 8-camera switcher reports all 8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
    [Web.cpp]
2026-09-10 Recall ladder: both-press falls in a dead zone (no action)
    Pressing both recall buttons puts the 10k + 3.3k legs in parallel, pulling GPIO34
    LOWER than recall2 alone (~814 vs ~1016 ADC). Add a floor under recall2 at 900 so
    a simultaneous press lands in a dead band and does nothing, instead of mis-firing
    recall2. The onboard BUT1 (~88) also lands in the dead band. Retune the three
    thresholds against real resistors via the "recall ladder ADC" log if needed.
2026-09-10 Display: center radar/zoom on the calibrated joystick center; drop dead UI helpers
    drawRadar() normalized pan/tilt/zoom against a fixed AnalogMax/2 midpoint, so the
    radar dot and zoom bar ignored a Recalibrate-center (settings.panMid/tiltMid/
    zoomMid) -- the dot sat off-center at rest and recalibrating did nothing on
    screen, even though the control loop already honored the calibrated center. Add
    axisNorm() to pivot each axis on its calibrated rest center (dot centered at rest,
    ends map to -1/+1; zoom bar half-full at rest). Recalibrating now re-centers the
    on-screen radar/zoom to match camera control.
    Also remove the dead pre-Arduino_GFX u8g2 helpers that were the last raw-pot /
    fixed-cente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
    [Display.cpp]
2026-09-10 Sim: show each camera's port (and ONVIF creds) on its view
    Overlay the connection details you type into the ChurchCam config right on each
    virtual camera view, so they're not buried in the code: port on all four, plus
    the ONVIF username/password where auth is required (Camera 3 = admin/churchcam;
    Camera 4 is anonymous). Client-side/UI only.
2026-09-10 Config: "Scan for ATEMs" button to auto-fill the ATEM IP
    Add a green button inline on the ATEM IP field (styled like the firmware-page
    buttons) that hits a new /discoverATEM endpoint. The handler runs the same mDNS
    query the firmware uses at boot (_blackmagic._tcp) and returns the switchers found
    as JSON; the page fills the IP field with the first result. Read-only -- does not
    change stored settings until Submit. Real ATEMs advertise via Bonjour; the sim's
    virtual ATEM does not advertise mDNS yet, so the scan finds nothing on the bench.
2026-09-11 Bring-up fixes: PSRAM, WebSocket crash, recall wiring, boot UX
    - platformio.ini: enable PSRAM on the WROVER-E build (dio_qspi + -DBOARD_HAS_PSRAM).
    Gives ~4 MB of heap and fixes the out-of-memory null-deref crash. setup() checks
    psramFound() and loudly flags a wrong (no-PSRAM) module in the serial log and via a
    red banner on the config page.
    - Web.cpp: fix the telemetry WebSocket use-after-free. broadcastTelemetry() now defers
    sendAll to the HTTP server task via httpd_queue_work(), so it no longer races the
    server task's client add/remove (was a LoadProhibited crash under load). A client
    counter skips the work when nobody is listening.
    - Controller.cpp: simplify the recall ladder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
    [ChurchCam.cpp, Controller.cpp, Display.cpp, Web.cpp, globals.h]
2026-09-13 Config AP: don't start it when Ethernet is up, and fix the grace-timer stall
    Two fixes to the "no network -> open a config hotspot" fallback:
    - On an Ethernet-primary unit with no WiFi SSID saved, networkSetup() used to bring
    the softAP up immediately, so the UI showed a hotspot even though ETH was the real
    network (and, with two interfaces up, wrong source-address selection could make
    camera connections intermittent). It now defers to loop context, which starts the
    AP only if no network (ETH or WiFi) appears within a grace window; ETH_GOT_IP
    cancels the request outright.
    - The grace timer was reset on every WiFi retry. The radio auto-retries a missing
    SSID every ~2.4s, so the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
    [Network.cpp]
2026-09-13 Fix joystick stall when reversing off a hard stop
    The camera-status poll does blocking socket I/O (hundreds of ms for an unreachable
    camera) on the joystick task, gated only on the stick being idle. But sweeping the
    stick through centre while reversing direction is momentarily idle, so a poll fired
    there and froze the joystick for ~half a second -- reliably, since the poll is
    always overdue after a stretch of driving. Require the stick to rest for a short
    settle before polling: quick reversals no longer trip it, a genuine pause still
    does (invisibly, since nothing is moving).
    [Controller.cpp]
2026-09-13 Add live-stream operator guide (docs/operator.html)
    One-page printable guide for volunteers: turn on power/PC, run the cameras
    (select on ATEM Preview, frame with the joystick, CUT to Program), go live and
    end the stream on the ATEM. Source of truth for the published artifact.
2026-10-31 Drain stale camera replies before a VISCA inquiry (camFlush)
    Drive/recall commands are fire-and-forget -- we never read the camera's
    ACK/Completion replies -- so on a TCP (or busy UDP) camera those replies queue in
    the socket buffer and the next status inquiry reads a stale one, misreporting a
    working camera as DOWN. Drain the socket right before an inquiry so it reads its
    own fresh reply.
2026-10-31 ATEM discovery: query both mDNS service names
    Blackmagic renamed the advertised mDNS service: current units (ATEM Mini Pro,
    confirmed on the church LAN at 192.168.1.240) advertise _switcher_ctrl._udp
    (port 9910); older/other models used _blackmagic._tcp. The firmware only queried
    the old name, so scan-for-ATEMs found nothing. Query the new name first (fall back
    to the old) at boot, and merge both in the /discoverATEM endpoint.
2026-10-31 Camera config: single "brand/connection" preset dropdown
    Replace the per-camera Type + Transport selects with one preset:
    Sony VISCA-over-IP (UDP 52381) · PTZOptics VISCA/TCP (5678)
    HuddleCam VISCA/UDP (1259) · ONVIF
    The preset maps to the existing type/transport/headers fields in handleSave (so no
    settings migration -- existing cameras map straight onto a preset), picks the right
    default port, and reveals ONVIF credentials. Framing is no longer derived from the
    transport, which is what made raw-UDP (HuddleCam) impossible to configure before.
2026-10-31 Full subnet scan for VISCA cameras (all dialects)
    Broadcast discovery only found framed VISCA-over-IP; TCP can't be
    broadcast at all, so raw cameras (HuddleCam UDP 1259, PTZOptics TCP
    5678) never showed up. Add a cooperative subnet sweep driven from the
    main loop, with a config-page progress bar fed by /scanProgress.
    CameraScan.cpp walks every host in the active interface's subnet
    (localIP() & subnetMask(), capped at 512) one host per scanTick(), so
    the web task keeps serving the progress poll while it runs. Each host
    is probed on all three dialects via standalone lwip sockets with
    bounded timeouts; a camera that answers more than one is registered
    under its most reliable transport (TCP > r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
2026-10-31 Firmware version tracking + pull-from-GitHub OTA
    Show the running firmware version on the config page and let the
    operator check the GitHub repo for a newer release and flash it
    directly, no cable or local .bin needed. Structured after the EllaFi
    project's GitHub OTA.
    Versioning: scripts/gen_version.py stamps -DFW_VERSION from
    `git describe --tags --always --dirty` at build time, so the version
    is the release tag (e.g. v1.2.0) once tagged, or the short commit for
    an untagged dev build. The config page's Firmware tab shows it.
    Check/compare: GET /checkUpdate queries
    api.github.com/repos/paulkilroy/ChurchCam/releases/latest server-side
    (the browser can't reach it cross-origin), with the User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
2026-10-31 Add scripts/release.sh: tag, build, publish a GitHub firmware release
    One command to cut a release so devices can self-update: it tags the
    commit, builds the firmware from that tag (so git-describe stamps the
    image with the tag), pushes the tag, and creates the GitHub Release
    with firmware.bin attached under the name the device's update check
    looks for. Requires the gh CLI.
2026-10-31 Retry the VISCA power inquiry so a camera isn't misread as down at boot
    The first inquiry to a camera after boot (or a long idle) is routinely
    lost: it's the packet that triggers ARP resolution, and lwIP drops it
    rather than queue it, so no reply comes and the camera reads DOWN
    (red) until the next ~8s status sweep corrects it. The config page's
    status is a page-load snapshot, so a user who loads it in that window
    sees a false "down" and has to refresh.
    A UDP recv timeout doesn't tear the socket down, and the first send
    resolves ARP, so a second attempt gets through. viscaStatus() now
    tries the inquiry twice before reporting DOWN; a healthy camera
    answers the first or second try, a genuinel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
2026-10-31 One "Scan for cameras" button; neutral WiFi status under Ethernet
    Camera discovery: collapse the separate "Scan Cameras" (broadcast +
    ONVIF) and "Full subnet scan" buttons into one "Scan for cameras".
    /scanSubnet now runs the quick broadcast VISCA + ONVIF discovery first
    to seed the list, then starts the full subnet sweep, which appends the
    raw/TCP cameras broadcast can't reach (de-duped by ip:port).
    resetDiscovered() moved out of scanStart() into the handler so the
    sweep doesn't wipe the broadcast seeds. The modal title now reflects
    the scanning state, and a note warns the scan can take a minute --
    it's a once-per-setup operation.
    WiFi status: when Ethernet holds the IP, a not-connected Wi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
2026-10-31 Camera status: fix boot timing, poll all at once on first pass
    The serial log showed camera 1 "down for several refreshes" was never a
    camera/network problem -- both cameras answer their power inquiry in
    ~20ms the instant they're polled. It was poll scheduling: camera 1's
    round-robin turn landed ~0.5s before ETH_GOT_IP, so it read NA; the
    old one-slot-per-second sweep across all 8 slots (6 of them empty) then
    didn't return to camera 1 for a full ~8s lap (13.6s), while camera 2,
    polled just after the IP arrived, came up at once.
    Rework pollCameraStatus() into three phases:
    1. Hold until networkUp() -- don't waste a camera's turn before the
    link has an IP.
    2. First pass (once, right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
2026-11-01 CI: build & publish firmware releases via GitHub Actions
    Add .github/workflows/release.yml: on a vX.Y.Z tag push, GitHub checks out the
    tagged commit, builds with PlatformIO, and publishes a release carrying
    firmware.bin -- the asset the device's GitHub OTA looks for. Because the build
    runs on the tag, gen_version.py stamps FW_VERSION from `git describe`, so the
    published image reports its own version.
    Slim scripts/release.sh to tag-and-push only; the build + upload now happen in
    CI, so it no longer needs a local PlatformIO build or the gh CLI.
